Foundation-Devices/passport-assembly/Mechanical Design Files/Solidworks Files/FD-1842_Battery-PCBA_v04_REFERENCE.SLDASM

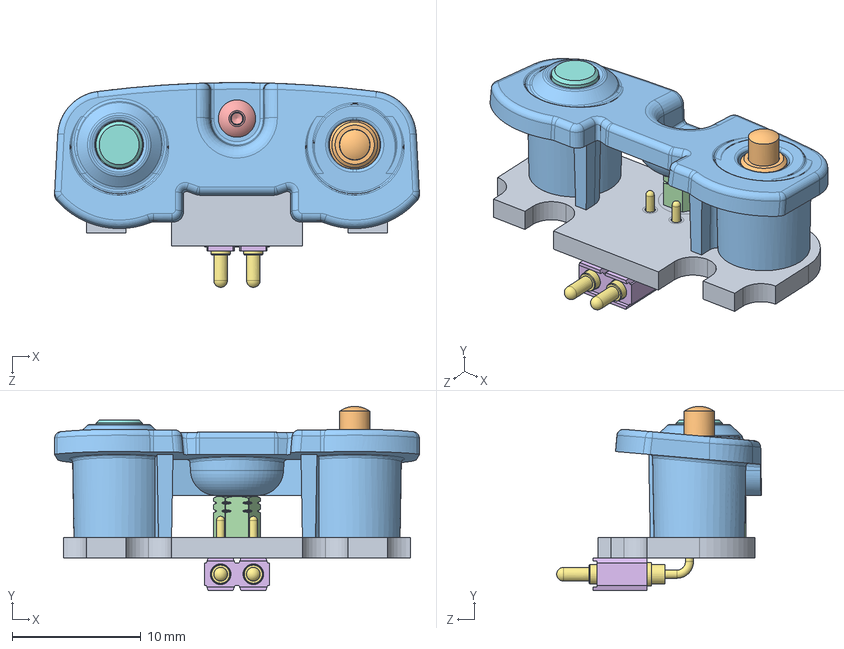
[picture p1: CAD file, 2021-05-18]
Mechanical Design Files/Solidworks Files/FD-1842_Battery-PCBA_v04_REFERENCE.SLDASM
28.3 x 14.3 x 15.9 mm
FD-1842_Battery-PCB_v04_REFERENCE
POGO-PIN_0871-0-15-20-82-14-11-0
FD_1842308-D_Battery-PCB-Chassis
NUT_PEM_SMTSO-080-4ET
SCREW_0-80_0188_BUTTON-HEX_92949A052
mill-max-829-22-002-20-002101_P8XX-11-013-30-000000
mill-max-829-22-002-20-002101_0970 x 2
mill-max-0393-0-15-15-07-XX-10-0
