Foundation-Devices/passport-assembly/Mechanical Design Files/Solidworks Files/FD-1842_Main-PCB_v03_REFERENCE.SLDPRT

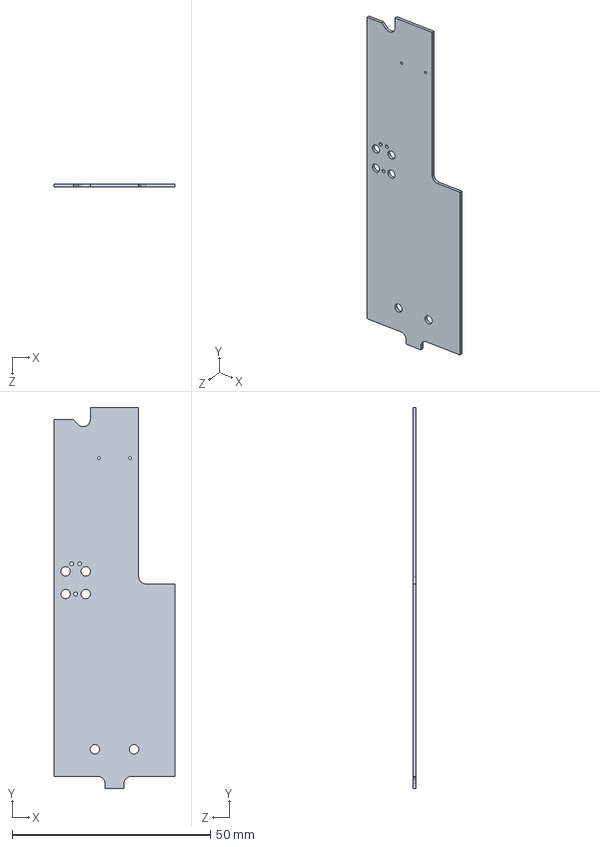
[picture p2: CAD file, 2021-05-18]
Mechanical Design Files/Solidworks Files/FD-1842_Main-PCB_v03_REFERENCE.SLDPRT
30.5 x 96.0 x 0.787 mm
