Foundation-Devices/passport-assembly/Mechanical Design Files/Solidworks Files/FD-1842_Dome-Array_v00.SLDASM

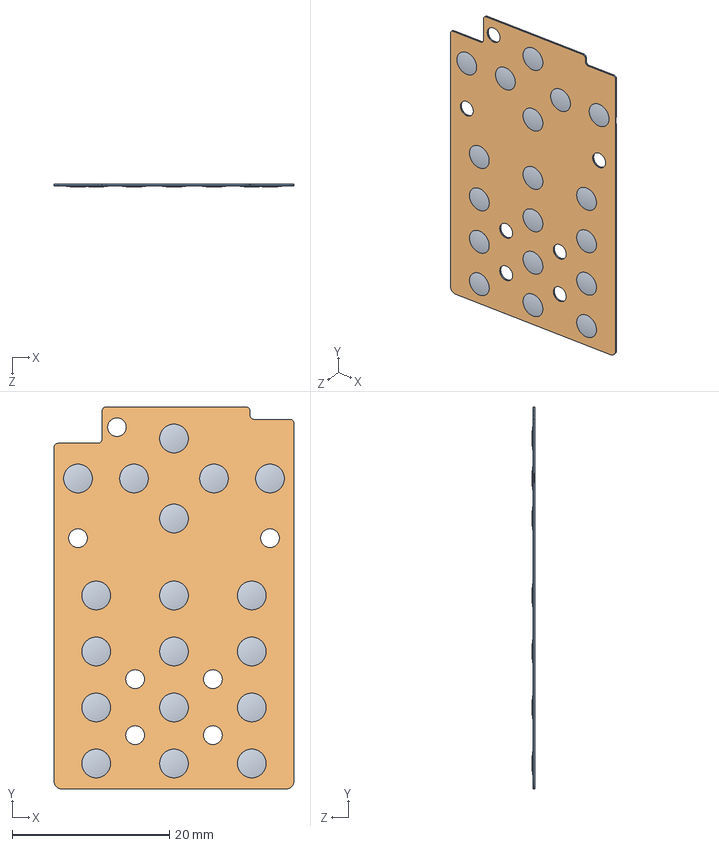
[picture p3: CAD file, 2021-05-18]
Mechanical Design Files/Solidworks Files/FD-1842_Dome-Array_v00.SLDASM
30.5 x 48.5 x 0.42 mm
DOME-SWITCH_6-SNL-170 x 18
005265042-A Dome Retainer-2020-09-04
005265043-A Dome Spacer-2020-09-04
