Foundation-Devices/passport-assembly/Mechanical Design Files/Solidworks Files/FD_1842102-B_Rear-Assem.SLDASM

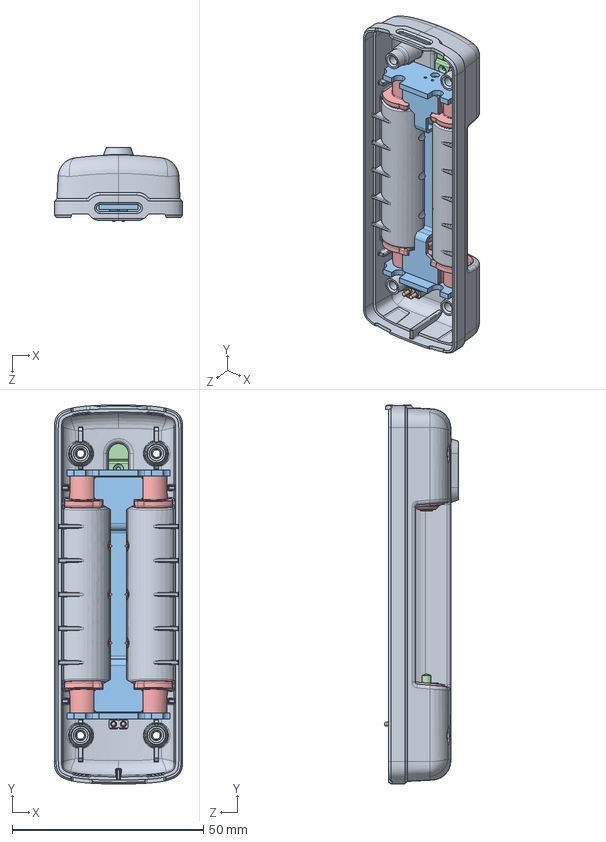
[picture p4: CAD file, 2021-05-18]
Mechanical Design Files/Solidworks Files/FD_1842102-B_Rear-Assem.SLDASM
33.5 x 99.1 x 19.5 mm
FD_1842301-C_Rear-Housing
MAGNET_0188-DIAx0188-H x 3
FD-1842_Battery-PCB_v04_REFERENCE x 2
POGO-PIN_0871-0-15-20-82-14-11-0 x 2
FD_1842308-D_Battery-PCB-Chassis x 2
NUT_PEM_SMTSO-080-4ET x 2
SCREW_0-80_0188_BUTTON-HEX_92949A052 x 2
mill-max-0393-0-15-15-07-XX-10-0 x 2
mill-max-829-22-002-20-002101_P8XX-11-013-30-000000
mill-max-829-22-002-20-002101_0970 x 2
FD_1842309-D_Retainer
FD_1842315-A_Flat-Camera-Shield
