Foundation-Devices/passport-assembly/Mechanical Design Files/Solidworks Files/FD_1842103-A_Rear-Cover-Assem.SLDASM

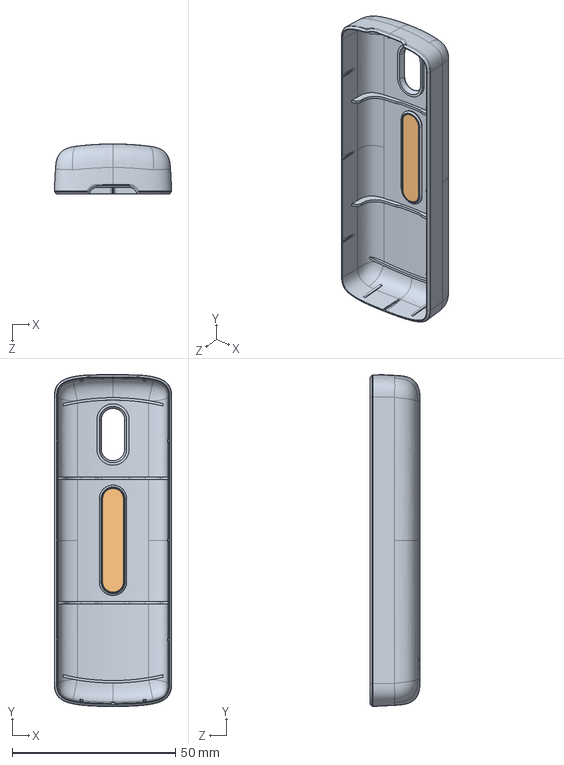
[picture p5: CAD file, 2021-05-18]
Mechanical Design Files/Solidworks Files/FD_1842103-A_Rear-Cover-Assem.SLDASM
36.0 x 101.6 x 15.4 mm
FD_1842302-C_Rear-Cover
FD_1842306-C_Steel-Plate
