Foundation-Devices/passport-assembly/Mechanical Design Files/STEP Files/FD_1842307-C_Bracket_SHEET-METAL-ONLY.STEP

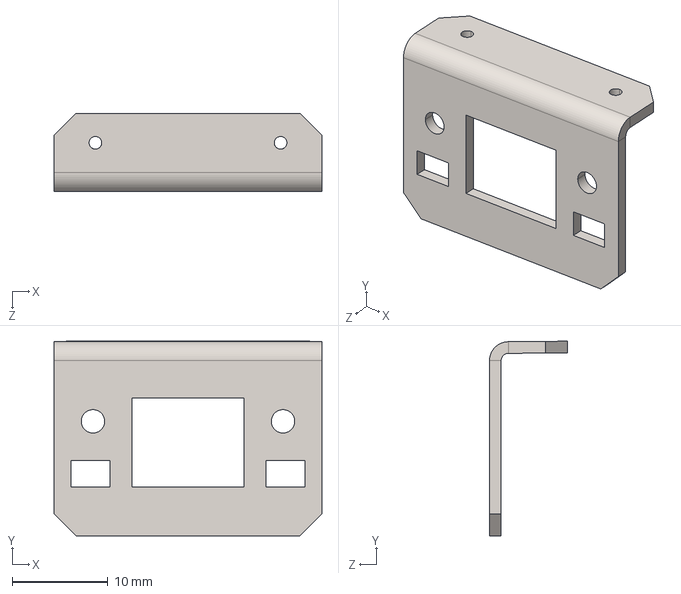
[picture p6: CAD file, 2021-05-18]
Mechanical Design Files/STEP Files/FD_1842307-C_Bracket_SHEET-METAL-ONLY.STEP
27.9 x 20.3 x 8.14 mm
