Foundation-Devices/passport-assembly/Mechanical Design Files/Solidworks Files/DOME-SWITCH_6-SNL-170.SLDPRT

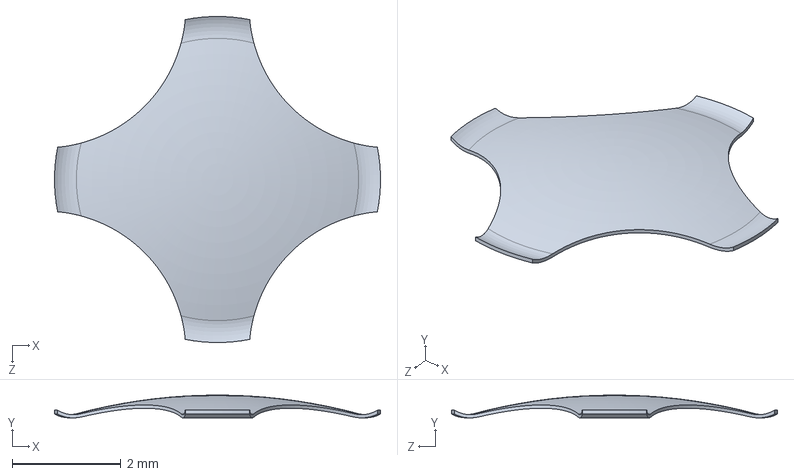
[picture p7: CAD file, 2021-05-18]
Mechanical Design Files/Solidworks Files/DOME-SWITCH_6-SNL-170.SLDPRT
6.00 x 0.42 x 6.00 mm
