Foundation-Devices/passport-assembly/Mechanical Design Files/STEP Files/FD_1842306-C_Steel-Plate.STEP

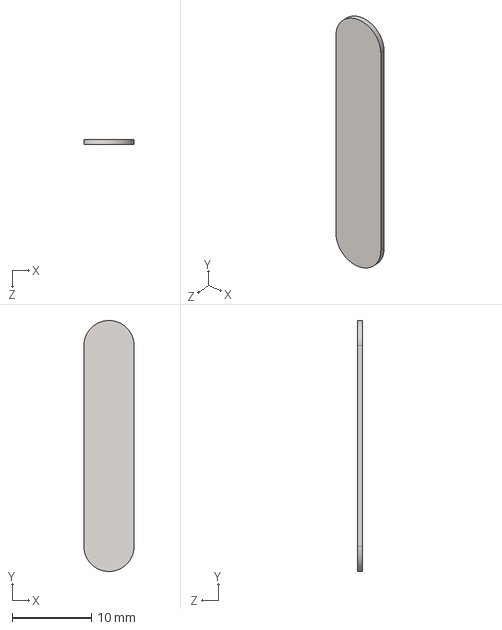
[picture p8: CAD file, 2021-05-18]
Mechanical Design Files/STEP Files/FD_1842306-C_Steel-Plate.STEP
6.35 x 31.8 x 0.61 mm
