Foundation-Devices/passport-assembly/Mechanical Design Files/Solidworks Files/FD-1842_Camera-PCB_v04_REFERENCE.SLDPRT

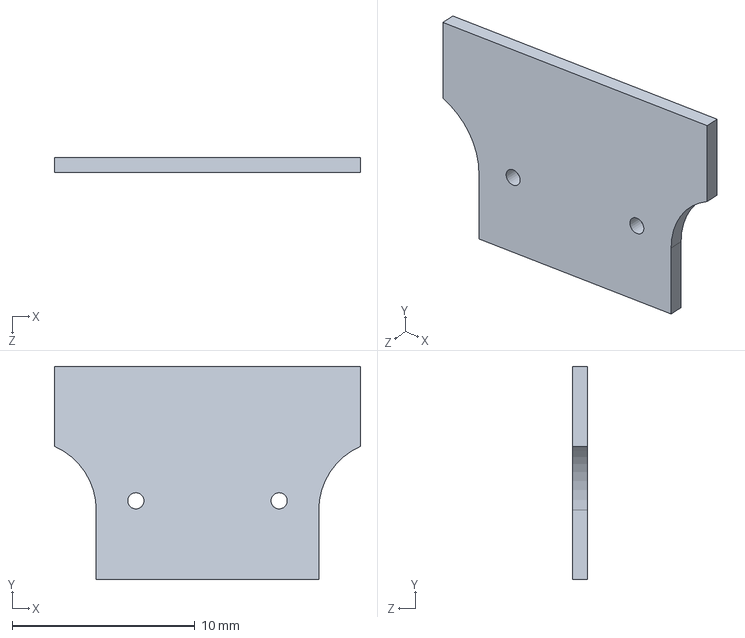
[picture p9: CAD file, 2021-05-18]
Mechanical Design Files/Solidworks Files/FD-1842_Camera-PCB_v04_REFERENCE.SLDPRT
16.8 x 11.7 x 0.813 mm
