Foundation-Devices/passport-assembly/Mechanical Design Files/STEP Files/FD_1842308-D_Battery-PCB-Chassis.STEP

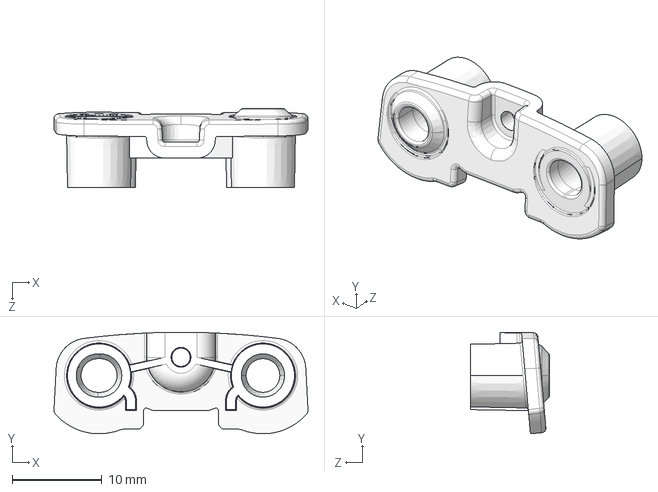
[picture p10: CAD file, 2021-05-18]
Mechanical Design Files/STEP Files/FD_1842308-D_Battery-PCB-Chassis.STEP
28.3 x 11.3 x 8.76 mm
