Foundation-Devices/passport-assembly/Mechanical Design Files/Solidworks Files/POGO-PIN_0871-0-15-20-82-14-11-0.SLDPRT

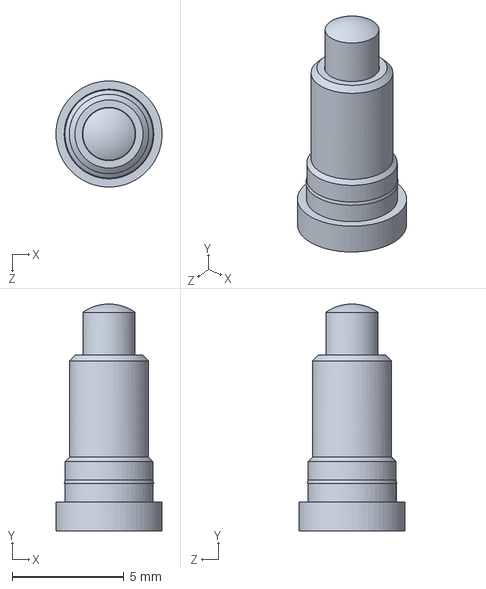
[picture p11: CAD file, 2021-05-18]
Mechanical Design Files/Solidworks Files/POGO-PIN_0871-0-15-20-82-14-11-0.SLDPRT
4.75 x 10.2 x 4.75 mm
