Foundation-Devices/passport-assembly/Mechanical Design Files/Solidworks Files/FD-JUL-CB1_PCB-2020-07-09.SLDPRT

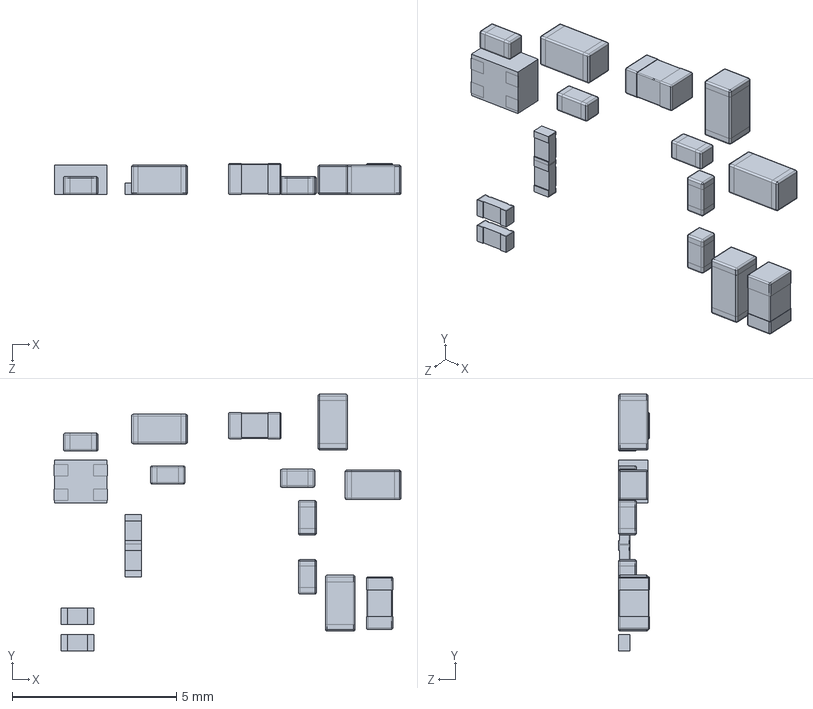
[picture p13: CAD file, 2021-05-18]
Mechanical Design Files/Solidworks Files/FD-JUL-CB1_PCB-2020-07-09.SLDPRT
10.6 x 7.81 x 0.953 mm
