Foundation-Devices/passport-assembly/Mechanical Design Files/STEP Files/FD_1842310-A_Light-Pipe.STEP

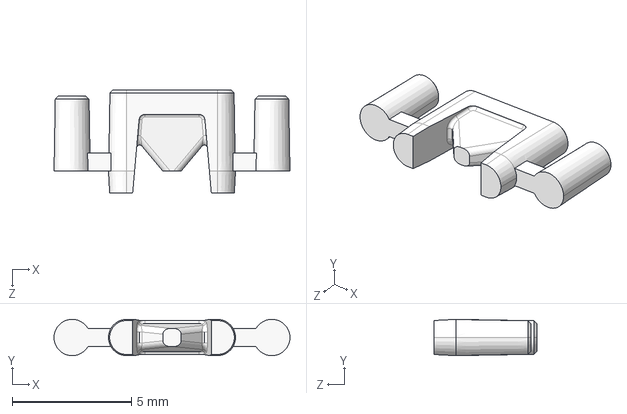
[picture p14: CAD file, 2021-05-18]
Mechanical Design Files/STEP Files/FD_1842310-A_Light-Pipe.STEP
9.91 x 1.52 x 4.32 mm
