Foundation-Devices/passport-assembly/Mechanical Design Files/Solidworks Files/FD_1842305-C_Camera-Shield.SLDPRT

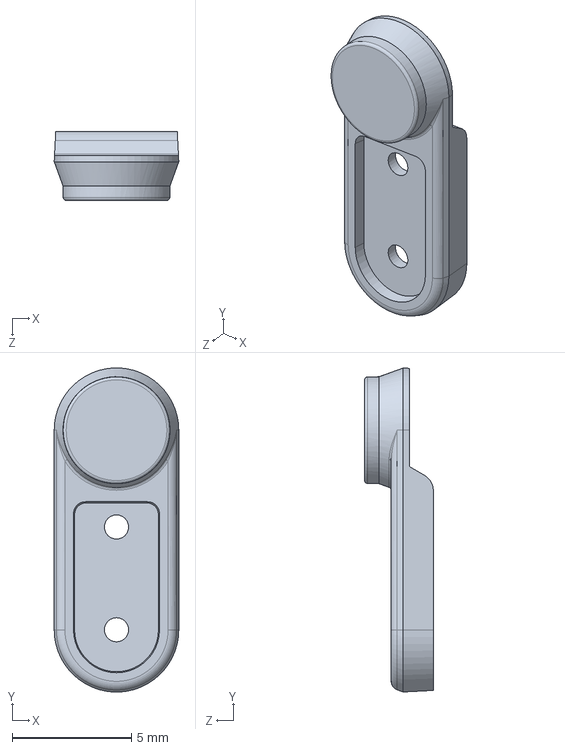
[picture p15: CAD file, 2021-05-18]
Mechanical Design Files/Solidworks Files/FD_1842305-C_Camera-Shield.SLDPRT
5.24 x 13.6 x 2.90 mm
