Foundation-Devices/passport-assembly/Mechanical Design Files/STEP Files/FD_1842312-A_Spacer.STEP

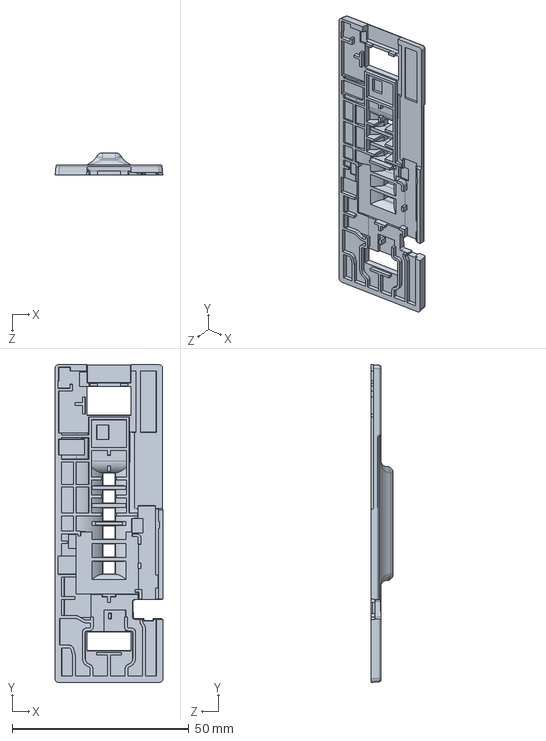
[picture p16: CAD file, 2021-05-18]
Mechanical Design Files/STEP Files/FD_1842312-A_Spacer.STEP
30.5 x 89.9 x 6.35 mm
