Foundation-Devices/passport-assembly/Mechanical Design Files/Solidworks Files/CAMERA_OVM7690-RYAA-BK.SLDPRT

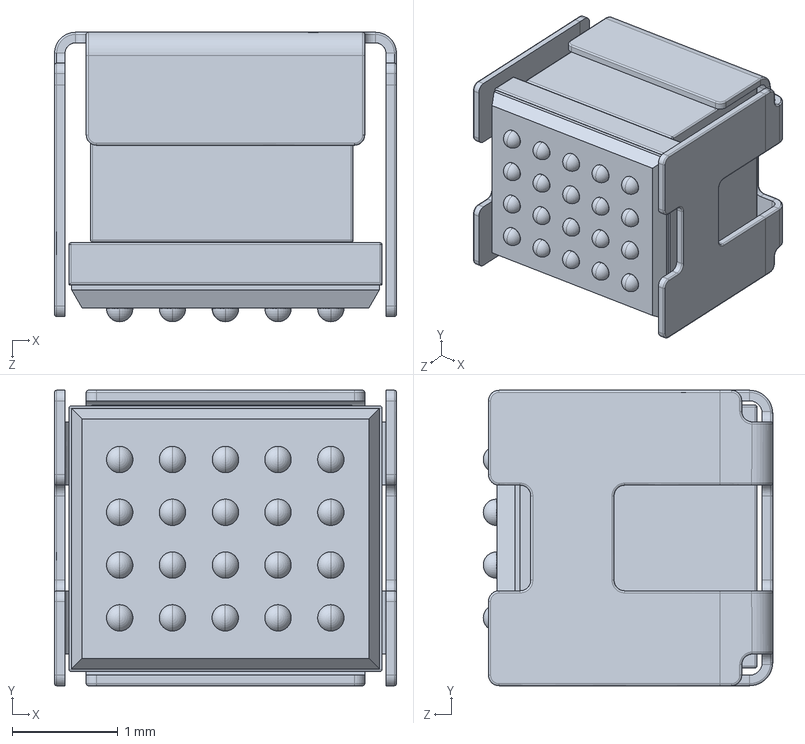
[picture p17: CAD file, 2021-05-18]
Mechanical Design Files/Solidworks Files/CAMERA_OVM7690-RYAA-BK.SLDPRT
3.24 x 2.80 x 2.74 mm
