Foundation-Devices/passport-assembly/Mechanical Design Files/STEP Files/FD_1842311-C_Display-Foam.STEP

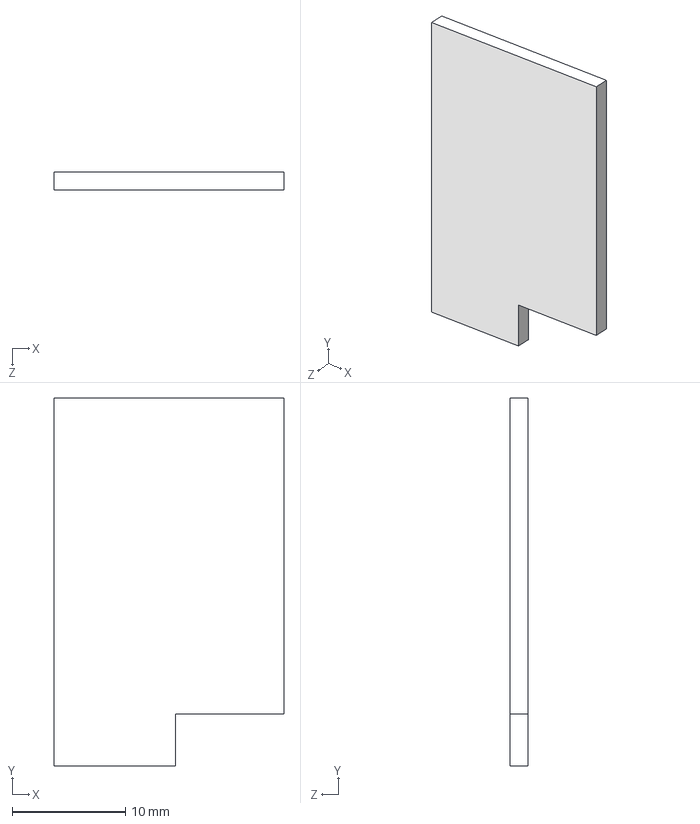
[picture p18: CAD file, 2021-05-18]
Mechanical Design Files/STEP Files/FD_1842311-C_Display-Foam.STEP
20.3 x 32.5 x 1.60 mm
