Foundation-Devices/passport-assembly/Mechanical Design Files/Solidworks Files/SD-CARD-RECEPTACLE_Molex-SD-47571-001.SLDPRT

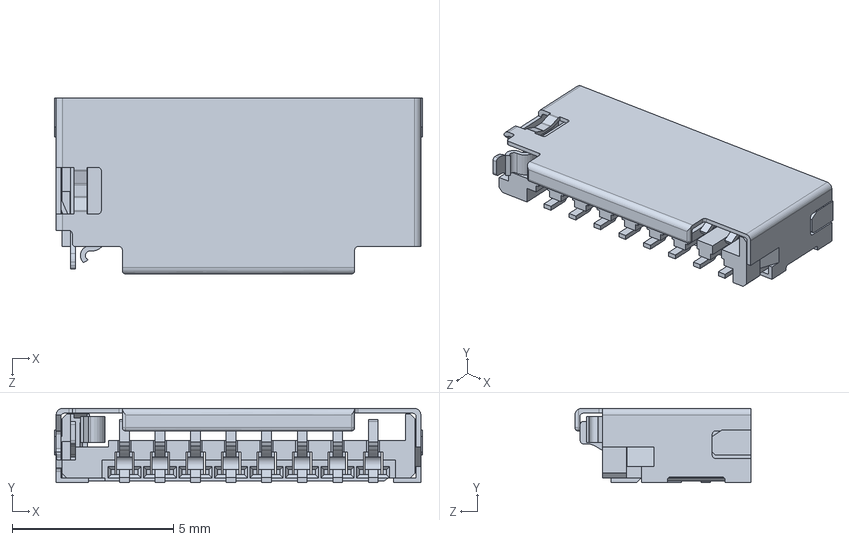
[picture p19: CAD file, 2021-05-18]
Mechanical Design Files/Solidworks Files/SD-CARD-RECEPTACLE_Molex-SD-47571-001.SLDPRT
11.4 x 2.30 x 5.45 mm
