Foundation-Devices/passport-assembly/Mechanical Design Files/STEP Files/FD_1842314-A_Programming-Fixture.STEP

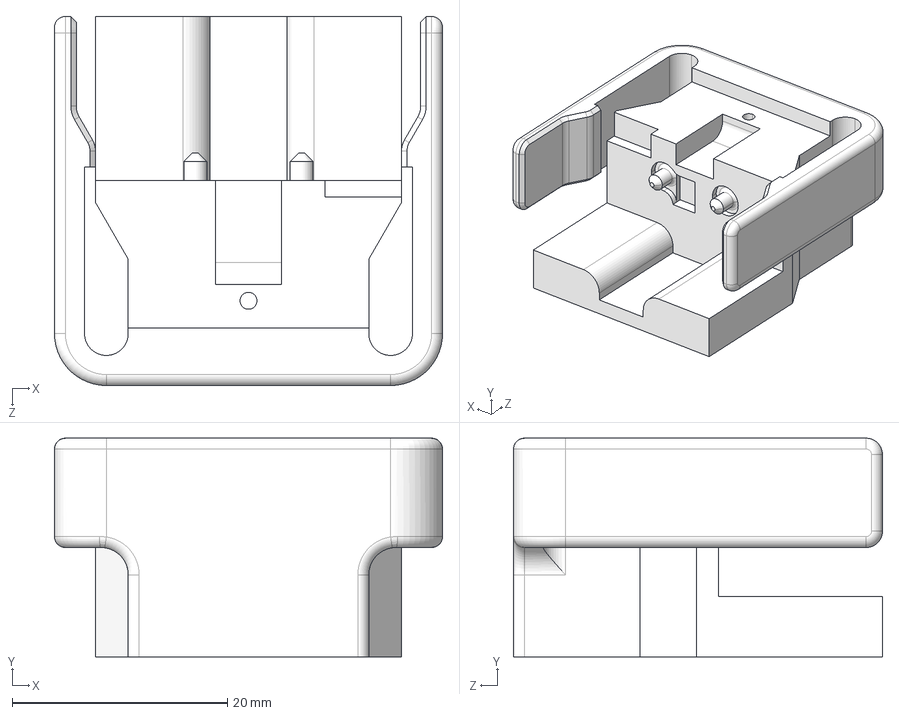
[picture p20: CAD file, 2021-05-18]
Mechanical Design Files/STEP Files/FD_1842314-A_Programming-Fixture.STEP
36.1 x 20.3 x 34.3 mm
