Foundation-Devices/passport-assembly/Mechanical Design Files/Solidworks Files/mill-max-0393-0-15-15-07-XX-10-0.SLDPRT

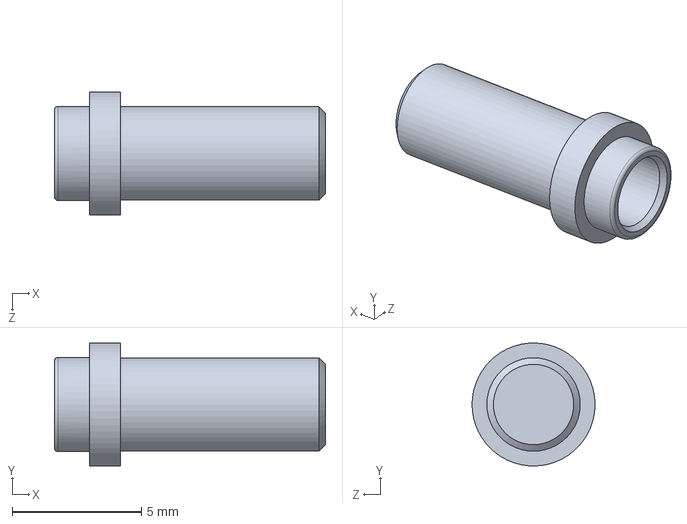
[picture p21: CAD file, 2021-05-18]
Mechanical Design Files/Solidworks Files/mill-max-0393-0-15-15-07-XX-10-0.SLDPRT
10.5 x 4.75 x 4.75 mm
