Foundation-Devices/passport-assembly/Mechanical Design Files/STEP Files/FD_1842309-D_Retainer.STEP

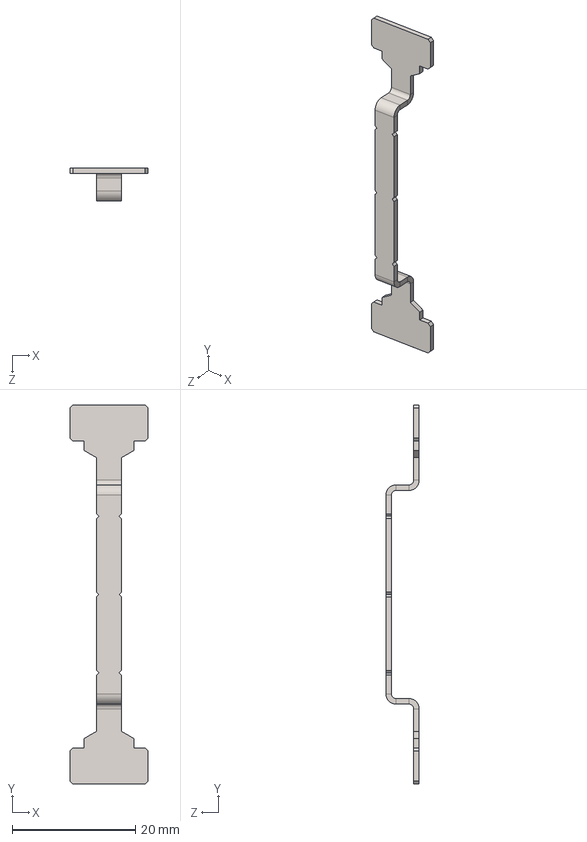
[picture p22: CAD file, 2021-05-18]
Mechanical Design Files/STEP Files/FD_1842309-D_Retainer.STEP
12.7 x 61.5 x 5.41 mm
