Foundation-Devices/passport-assembly/Mechanical Design Files/STEP Files/FD_1842307-C_Bracket.STEP

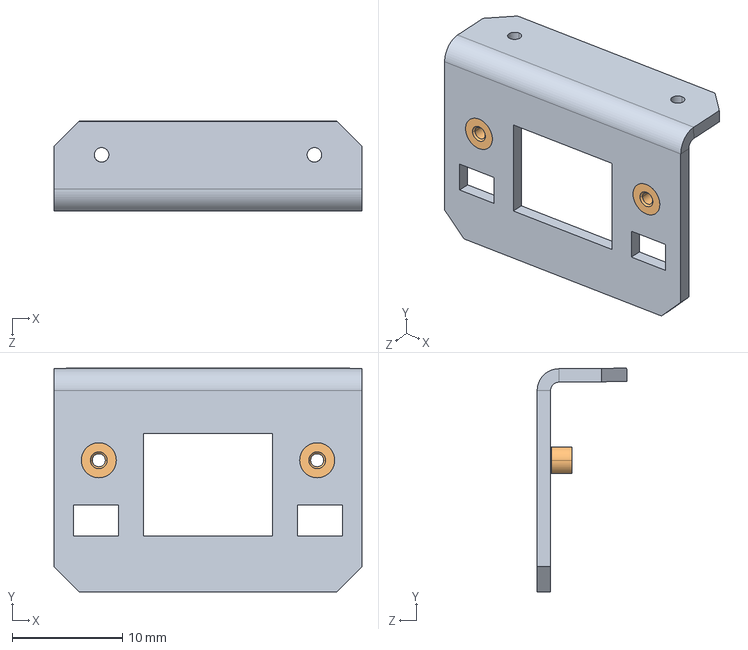
[picture p23: CAD file, 2021-05-18]
Mechanical Design Files/STEP Files/FD_1842307-C_Bracket.STEP
27.9 x 20.3 x 8.14 mm
FD_1842307-C_Bracket
STANDOFF_PEM_MSO4-080-4 x 2
