Foundation-Devices/passport-assembly/Mechanical Design Files/Solidworks Files/OPTICAL-SENSOR_ON-SEMI_LV0104CS.SLDPRT

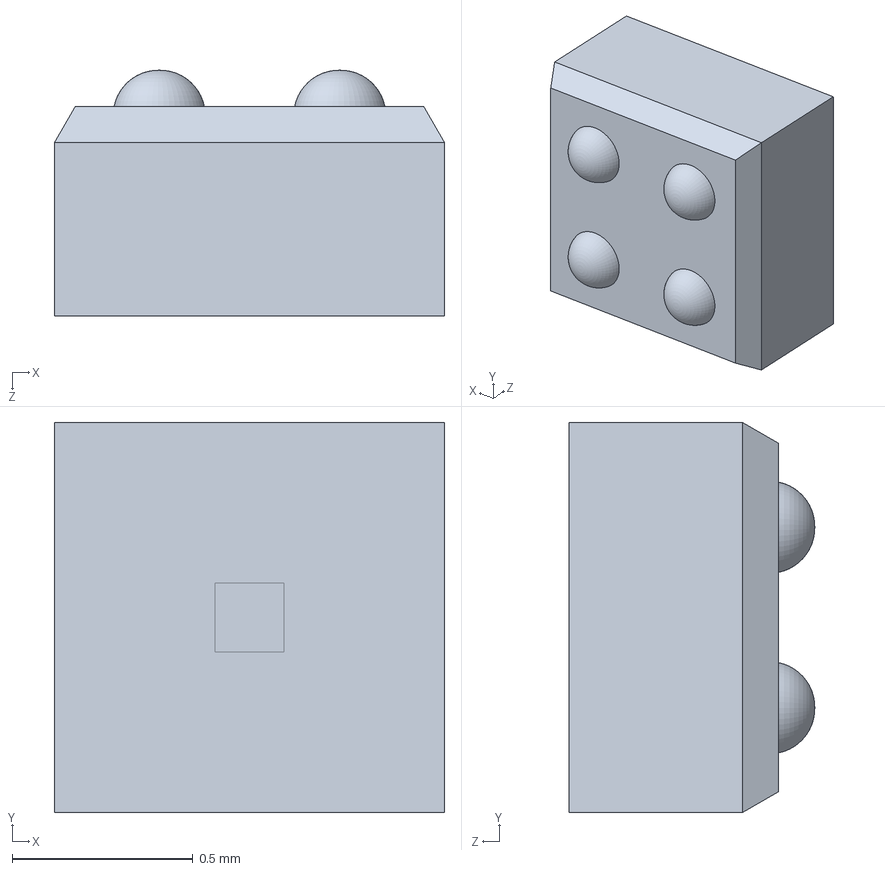
[picture p24: CAD file, 2021-05-18]
Mechanical Design Files/Solidworks Files/OPTICAL-SENSOR_ON-SEMI_LV0104CS.SLDPRT
1.08 x 1.08 x 0.68 mm
