Foundation-Devices/passport-assembly/Mechanical Design Files/STEP Files/FD_1842302-C_Rear-Cover.STEP

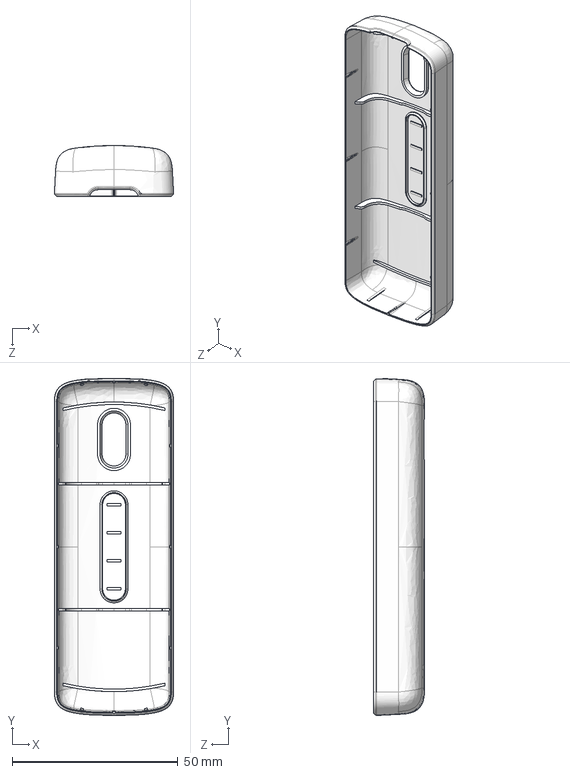
[picture p25: CAD file, 2021-05-18]
Mechanical Design Files/STEP Files/FD_1842302-C_Rear-Cover.STEP
36.0 x 101.6 x 15.4 mm
