Foundation-Devices/passport-assembly/Mechanical Design Files/Solidworks Files/MAGNET_0188-DIAx0188-H.SLDPRT

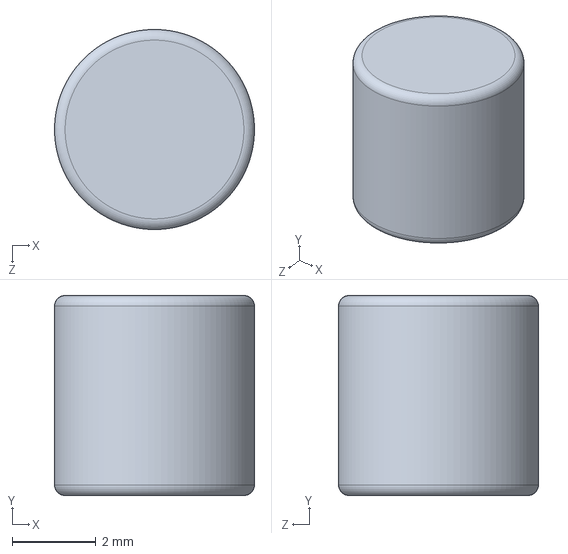
[picture p26: CAD file, 2021-05-18]
Mechanical Design Files/Solidworks Files/MAGNET_0188-DIAx0188-H.SLDPRT
4.77 x 4.78 x 4.77 mm
