Foundation-Devices/passport-assembly/Mechanical Design Files/STEP Files/FD_1842304-H_Display-Shield.STEP

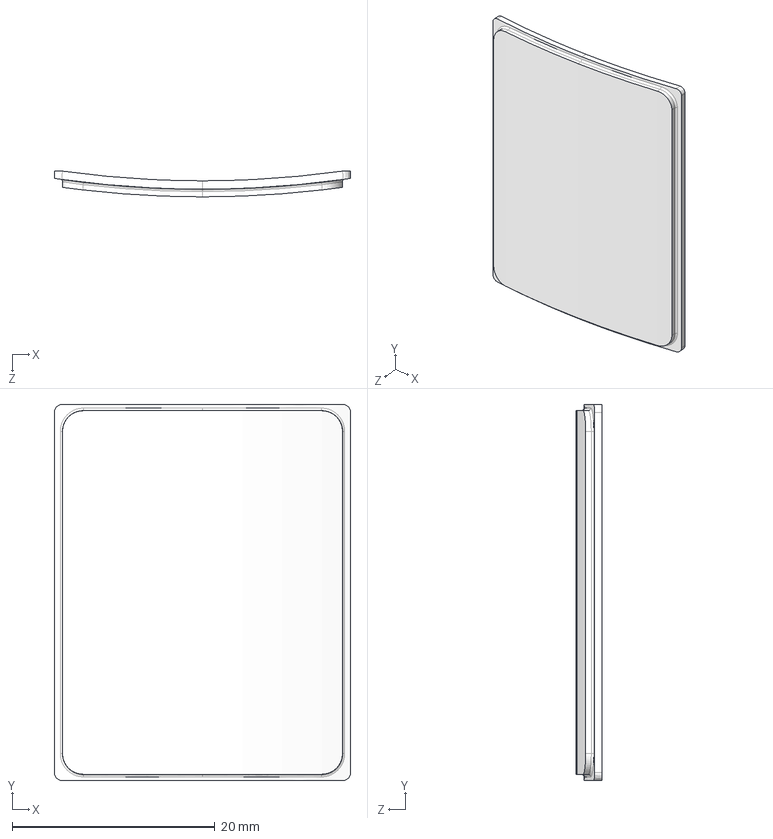
[picture p27: CAD file, 2021-05-18]
Mechanical Design Files/STEP Files/FD_1842304-H_Display-Shield.STEP
29.2 x 37.1 x 2.54 mm
