Foundation-Devices/passport-assembly/Mechanical Design Files/Solidworks Files/FD-1842_Battery-PCB_v04_REFERENCE.SLDPRT

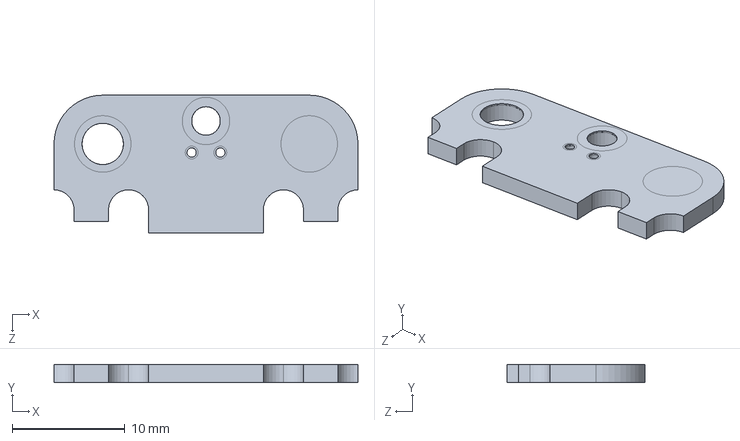
[picture p28: CAD file, 2021-05-18]
Mechanical Design Files/Solidworks Files/FD-1842_Battery-PCB_v04_REFERENCE.SLDPRT
26.9 x 1.60 x 12.2 mm
