Foundation-Devices/passport-assembly/Mechanical Design Files/Solidworks Files/mill-max-829-22-002-20-002101_P8XX-11-013-30-000000.sldprt

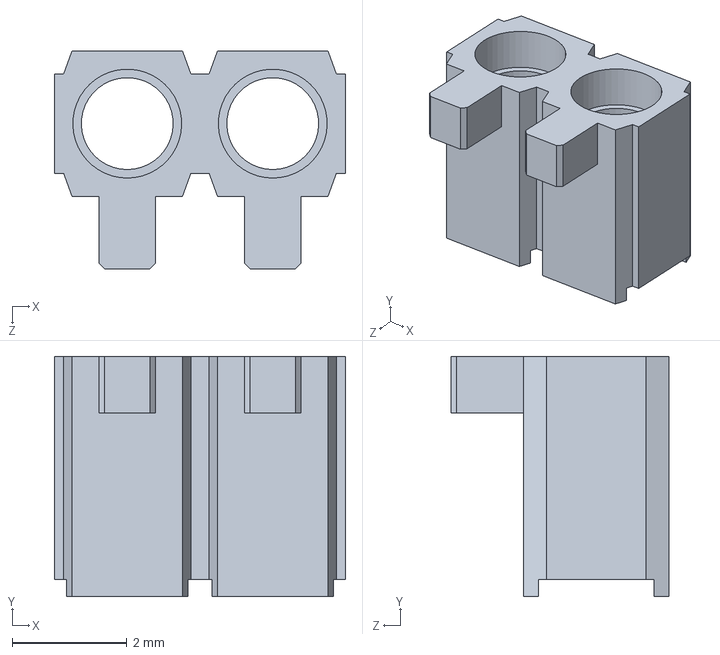
[picture p29: CAD file, 2021-05-18]
Mechanical Design Files/Solidworks Files/mill-max-829-22-002-20-002101_P8XX-11-013-30-000000.sldprt
5.08 x 4.19 x 3.81 mm
