Foundation-Devices/passport-assembly/Mechanical Design Files/Solidworks Files/FLEX-DISPLAY_FLAT-ROLL_12616-06_T2_prelim_08-28-2019_REF.SLDPRT

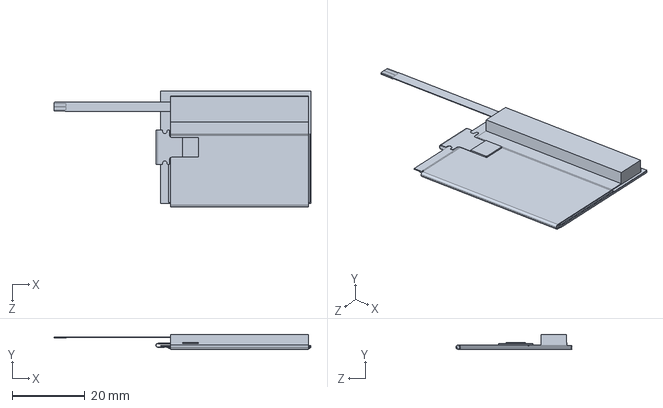
[picture p30: CAD file, 2021-05-18]
Mechanical Design Files/Solidworks Files/FLEX-DISPLAY_FLAT-ROLL_12616-06_T2_prelim_08-28-2019_REF.SLDPRT
70.8 x 4.06 x 32.0 mm
