Foundation-Devices/passport-assembly/Mechanical Design Files/Solidworks Files/mill-max-829-22-002-20-002101_0970.sldprt

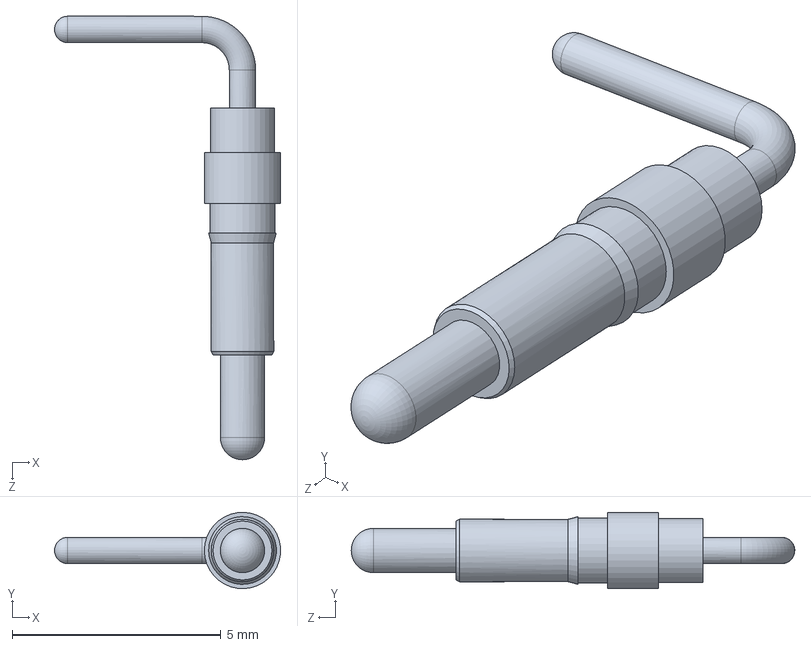
[picture p31: CAD file, 2021-05-18]
Mechanical Design Files/Solidworks Files/mill-max-829-22-002-20-002101_0970.sldprt
5.42 x 1.83 x 10.6 mm
