Foundation-Devices/passport-assembly/Mechanical Design Files/Solidworks Files/DISPLAY-RECEPTACLE_TE-CONNECTIVITY_1-2328702-0.SLDPRT

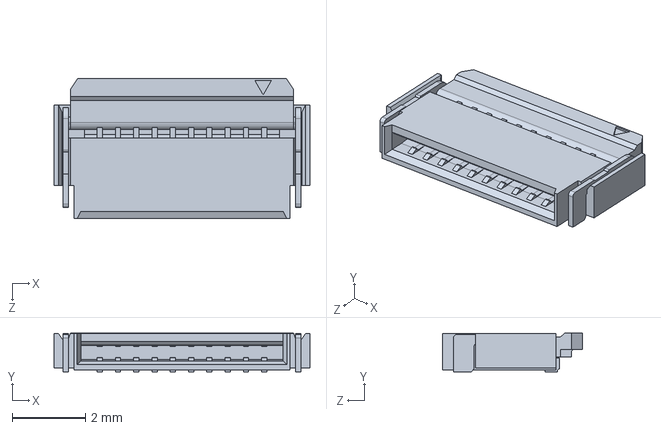
[picture p32: CAD file, 2021-05-18]
Mechanical Design Files/Solidworks Files/DISPLAY-RECEPTACLE_TE-CONNECTIVITY_1-2328702-0.SLDPRT
7.00 x 1.06 x 3.83 mm
