Foundation-Devices/passport-assembly/Mechanical Design Files/Solidworks Files/Battery-AAA.SLDPRT

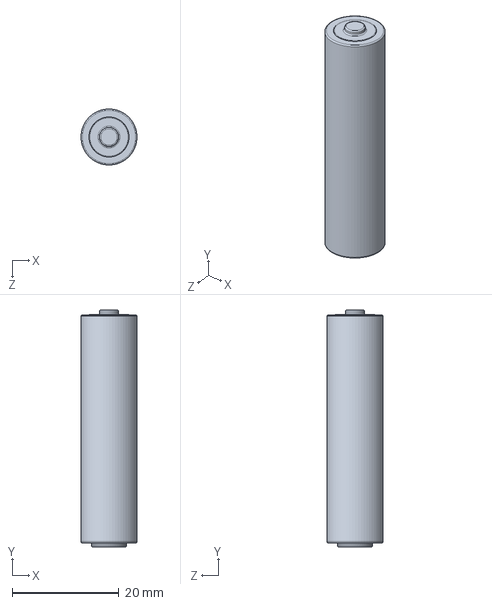
[picture p33: CAD file, 2021-05-18]
Mechanical Design Files/Solidworks Files/Battery-AAA.SLDPRT
10.5 x 44.4 x 10.5 mm
