Foundation-Devices/passport-assembly/Mechanical Design Files/Solidworks Files/LED_LTST-C190XXXX.SLDPRT

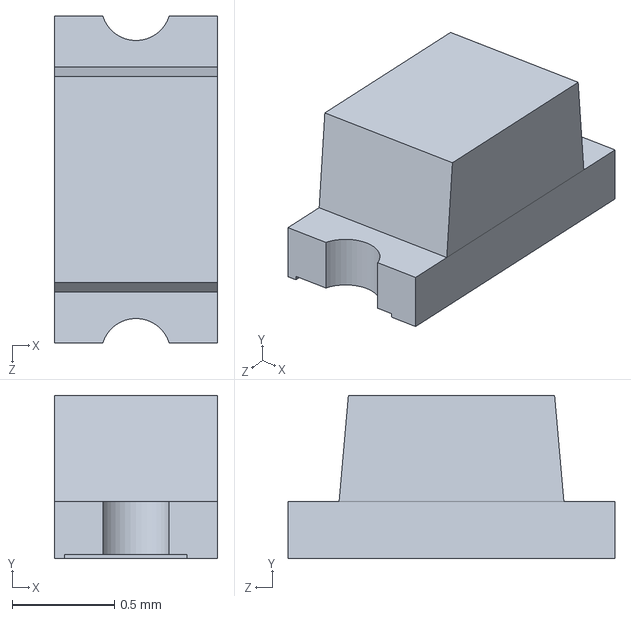
[picture p34: CAD file, 2021-05-18]
Mechanical Design Files/Solidworks Files/LED_LTST-C190XXXX.SLDPRT
0.8 x 0.8 x 1.60 mm
