Foundation-Devices/passport-assembly/Mechanical Design Files/Solidworks Files/XT_FD-JL-PCBA-CB_D3_2020-11-23-2.SLDPRT

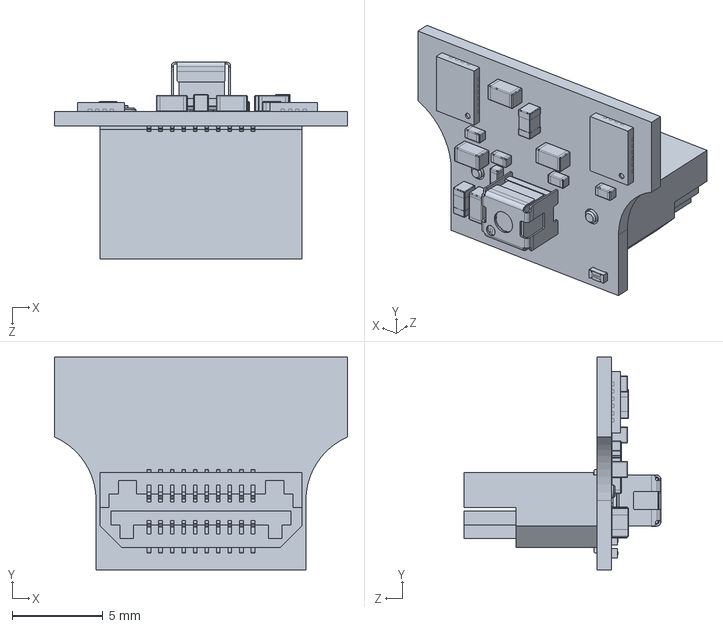
[picture p35: CAD file, 2021-05-18]
Mechanical Design Files/Solidworks Files/XT_FD-JL-PCBA-CB_D3_2020-11-23-2.SLDPRT
16.1 x 11.7 x 10.8 mm
