Foundation-Devices/passport-assembly/Mechanical Design Files/Solidworks Files/STANDOFF_PEM_MSO4-080-4.SLDPRT

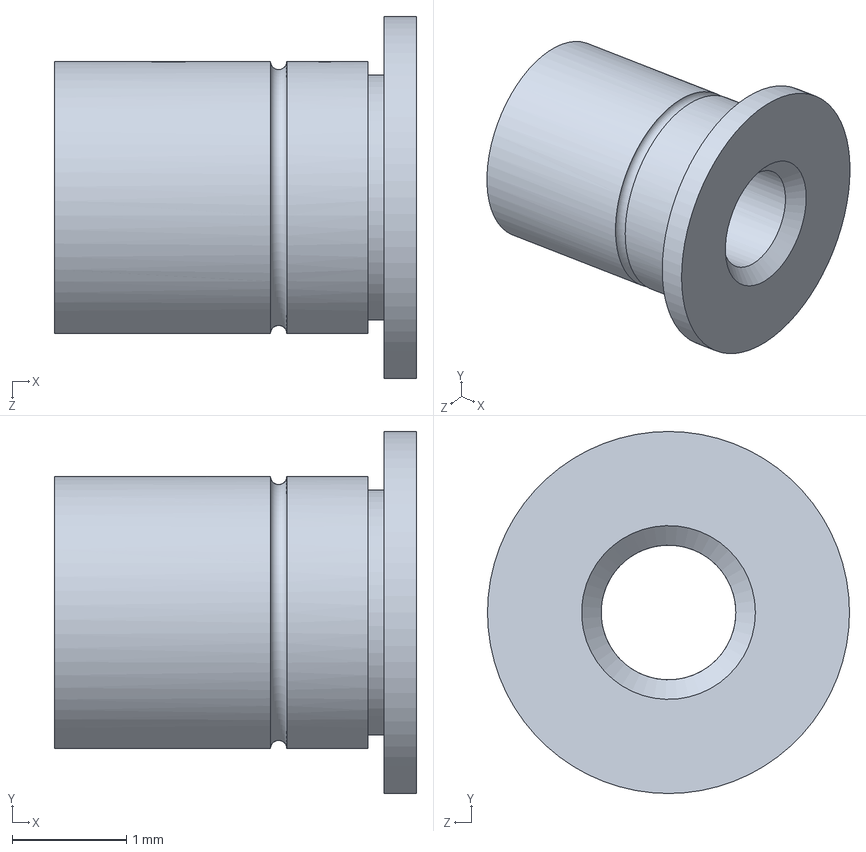
[picture p36: CAD file, 2021-05-18]
Mechanical Design Files/Solidworks Files/STANDOFF_PEM_MSO4-080-4.SLDPRT
3.17 x 3.17 x 3.17 mm
