Foundation-Devices/passport-assembly/(list of files, cad)

Other CAD files:
Mechanical Design Files/Archive/Original Camera Shield/FD_1842305-C_Camera-Shield.STEP
Mechanical Design Files/Archive/Original Camera Shield/FD_1842305-C_Camera-Shield.STL
Mechanical Design Files/DXF Files/FD_1842311-C_Display-Foam.DXF
Mechanical Design Files/DXF Files/FD_1842315-A_Flat-Camera-Shield.DXF
Mechanical Design Files/STL Files/FD_1842304-H_Display-Shield.STL
Mechanical Design Files/STL Files/FD_1842306-C_Steel-Plate.STL
Mechanical Design Files/STL Files/FD_1842307-C_Bracket.STL
Mechanical Design Files/STL Files/FD_1842307-C_Bracket_SHEET-METAL-ONLY.STL
Mechanical Design Files/STL Files/FD_1842309-D_Retainer.STL
Mechanical Design Files/STL Files/FD_1842310-A_Light-Pipe.STL
Mechanical Design Files/STL Files/FD_1842311-C_Display-Foam.STL
Mechanical Design Files/STL Files/FD_1842312-A_Spacer.STL
Mechanical Design Files/STL Files/FD_1842314-A_Programming-Fixture.STL
Mechanical Design Files/STL Files/FD_1842315-A_Flat-Camera-Shield.STL
Mechanical Design Files/Solidworks Files/005265012-A Assembly, Keypad-2020-09-04.sldasm
Mechanical Design Files/Solidworks Files/005265021-A Keytop, Set-2020-09-04.sldprt
Mechanical Design Files/Solidworks Files/005265032-A Keypad, Base-2020-09-04.sldprt
Mechanical Design Files/Solidworks Files/005265041-A Metal Dome Array-2020-09-04.sldasm
Mechanical Design Files/Solidworks Files/005265042-A Dome Retainer-2020-09-04.sldprt
Mechanical Design Files/Solidworks Files/005265043-A Dome Spacer-2020-09-04.sldprt
Mechanical Design Files/Solidworks Files/FD-1842_Dome-Array_v00.SLDPRT
Mechanical Design Files/Solidworks Files/FD_1842302-C_Rear-Cover.SLDPRT
Mechanical Design Files/Solidworks Files/FD_1842304-H_Display-Shield.SLDPRT
Mechanical Design Files/Solidworks Files/FD_1842306-C_Steel-Plate.SLDPRT
Mechanical Design Files/Solidworks Files/FD_1842307-C_Bracket.SLDASM
Mechanical Design Files/Solidworks Files/FD_1842307-C_Bracket.SLDPRT
Mechanical Design Files/Solidworks Files/FD_1842307-C_Bracket_SHEET-METAL-ONLY.SLDPRT
Mechanical Design Files/Solidworks Files/FD_1842308-D_Battery-PCB-Chassis.SLDPRT
Mechanical Design Files/Solidworks Files/FD_1842309-D_Retainer.SLDPRT
Mechanical Design Files/Solidworks Files/FD_1842310-A_Light-Pipe.SLDPRT
Mechanical Design Files/Solidworks Files/FD_1842311-C_Display-Foam.SLDPRT
Mechanical Design Files/Solidworks Files/FD_1842312-A_Spacer.SLDPRT
Mechanical Design Files/Solidworks Files/FD_1842315-A_Flat-Camera-Shield.SLDPRT
Mechanical Design Files/Solidworks Files/NUT_PEM_SMTSO-080-4ET.SLDPRT
Mechanical Design Files/Solidworks Files/SCREW_0-80_0188_BUTTON-HEX_92949A052.SLDPRT
