Foundation-Devices/passport-assembly/Mechanical Design Files/PDF Drawings/FD_1842300-H_Front-Housing.PDF

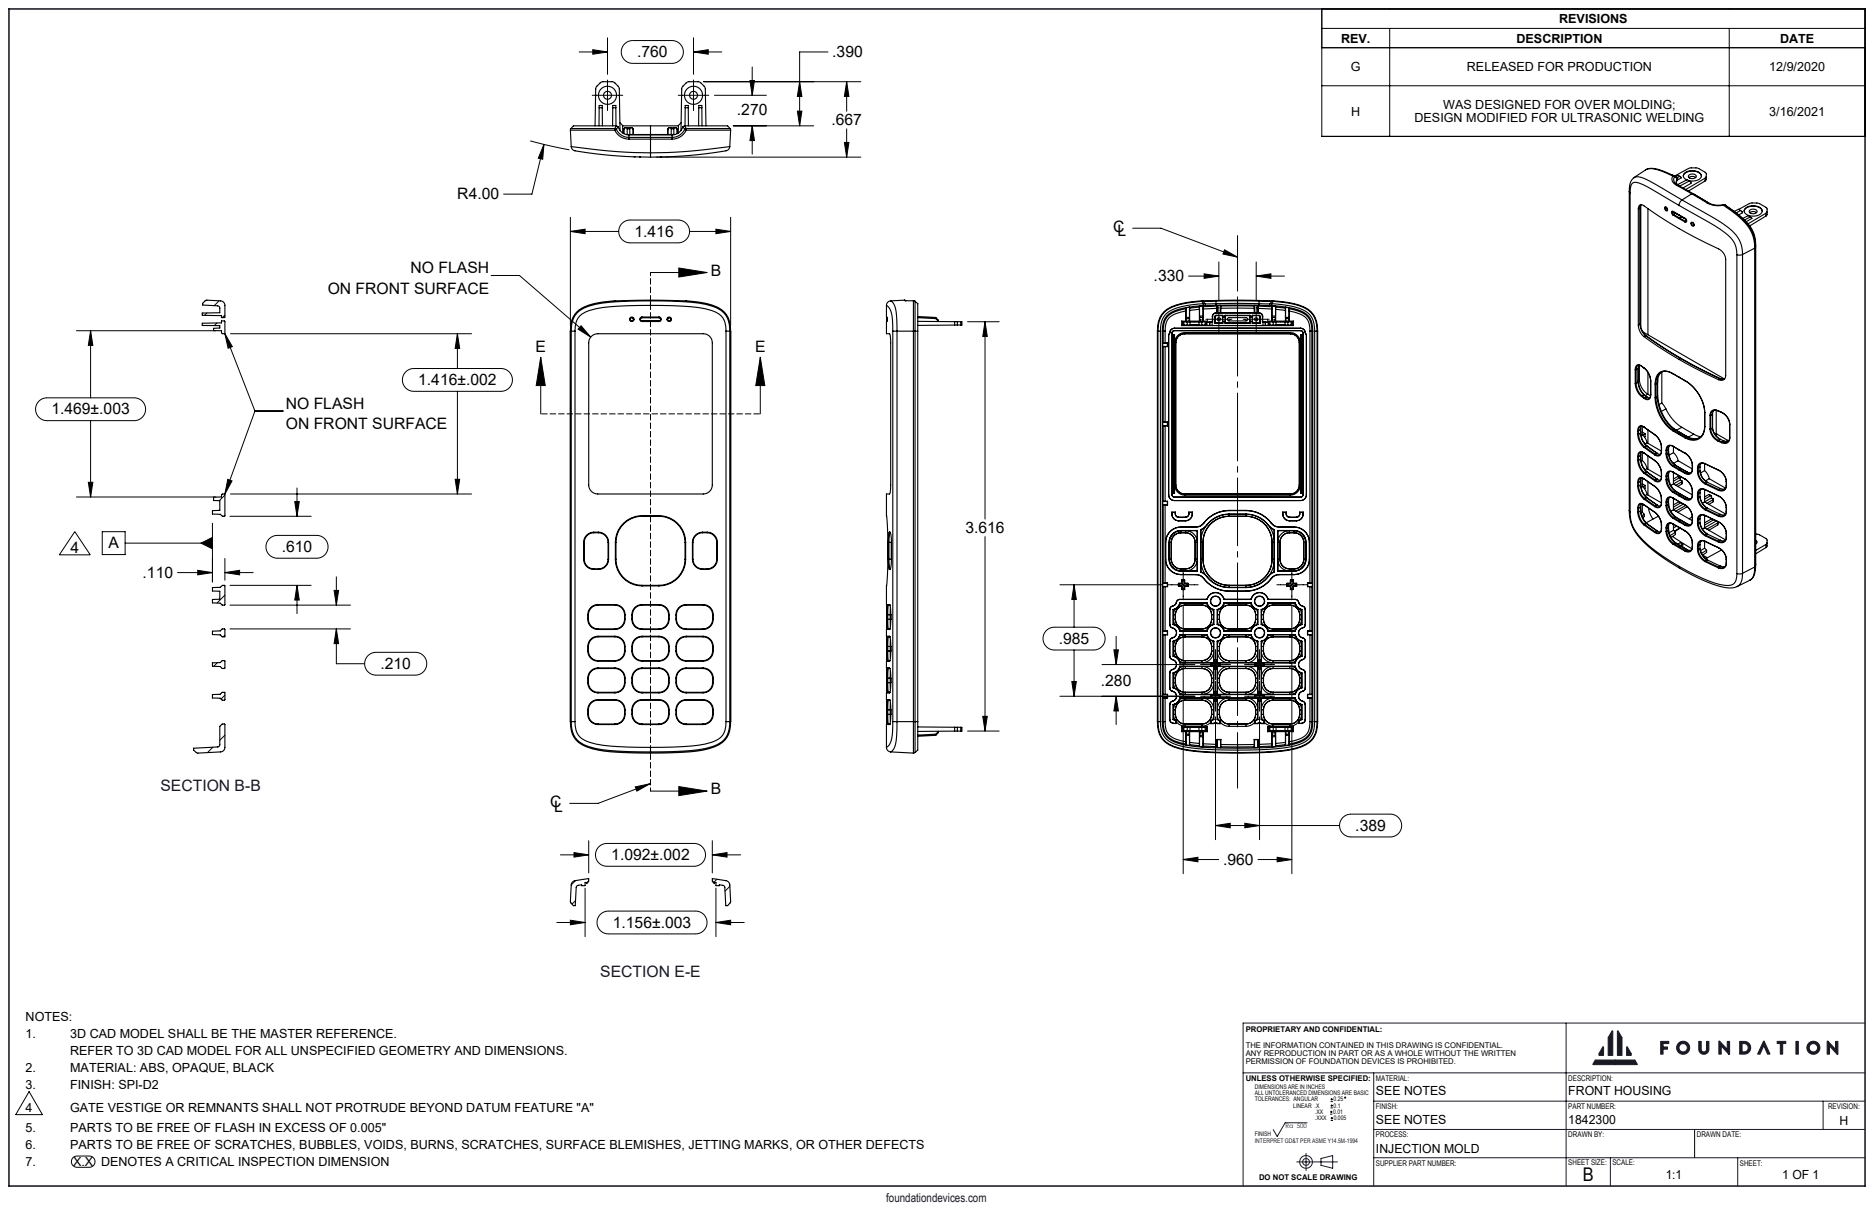
[picture p37: page 1]
NO FLASH; SECTION B-B; SECTION E-E; GATE VESTIGE OR REMNANTS SHALL NOT PROTRUDE BEYOND DATUM FEATURE "A"

REVISIONS

REV. | DESCRIPTION | DATE
G | RELEASED FOR PRODUCTION | 12/9/2020

H | WAS DESIGNED FOR OVER MOLDING; DESIGN MODIFIED FOR ULTRASONIC WELDING | 3/16/2021

ON FRONT SURFACE

NO FLASH

NOTES:
1. 3D CAD MODEL SHALL BE THE MASTER REFERENCE.
REFER TO 3D CAD MODEL FOR ALL UNSPECIFIED GEOMETRY AND DIMENSIONS.
2. MATERIAL: ABS, OPAQUE, BLACK
3. FINISH: SPI-D2
5. PARTS TO BE FREE OF FLASH IN EXCESS OF 0.005"
6. PARTS TO BE FREE OF SCRATCHES, BUBBLES, VOIDS, BURNS, SCRATCHES, SURFACE BLEMISHES, JETTING MARKS, OR OTHER DEFECTS
7. X.X DENOTES A CRITICAL INSPECTION DIMENSION

PROPRIETARY AND CONFIDENTIAL: THE INFORMATION CONTAINED IN THIS DRAWING IS CONFIDENTIAL. ANY REPRODUCTION IN PART OR AS A WHOLE WITHOUT THE WRITTEN PERMISSION OF FOUNDATION DEVICES IS PROHIBITED.

UNLESS OTHERWISE SPECIFIED: DIMENSIONS ARE IN INCHES ALL UNTOLERANCED DIMENSIONS ARE BASIC TOLERANCES: ANGULAR 0.25 LINEAR .X 0.1 .XX 0.01 .XXX 0.005 Ra 500 FINISH INTERPRET GD&T PER ASME Y14.5M-1994 DO NOT SCALE DRAWING | MATERIAL: SEE NOTES | DESCRIPTION: FRONT HOUSING

FINISH: SEE NOTES | PART NUMBER: 1842300 | REVISION: H

PROCESS: INJECTION MOLD | DRAWN BY: | DRAWN DATE:
SUPPLIER PART NUMBER: | SHEET SIZE: B | SCALE: 1:1 | SHEET: 1 OF 1
