Foundation-Devices/passport-assembly/Mechanical Design Files/PDF Drawings/FD_1842302-C_Rear-Cover.PDF

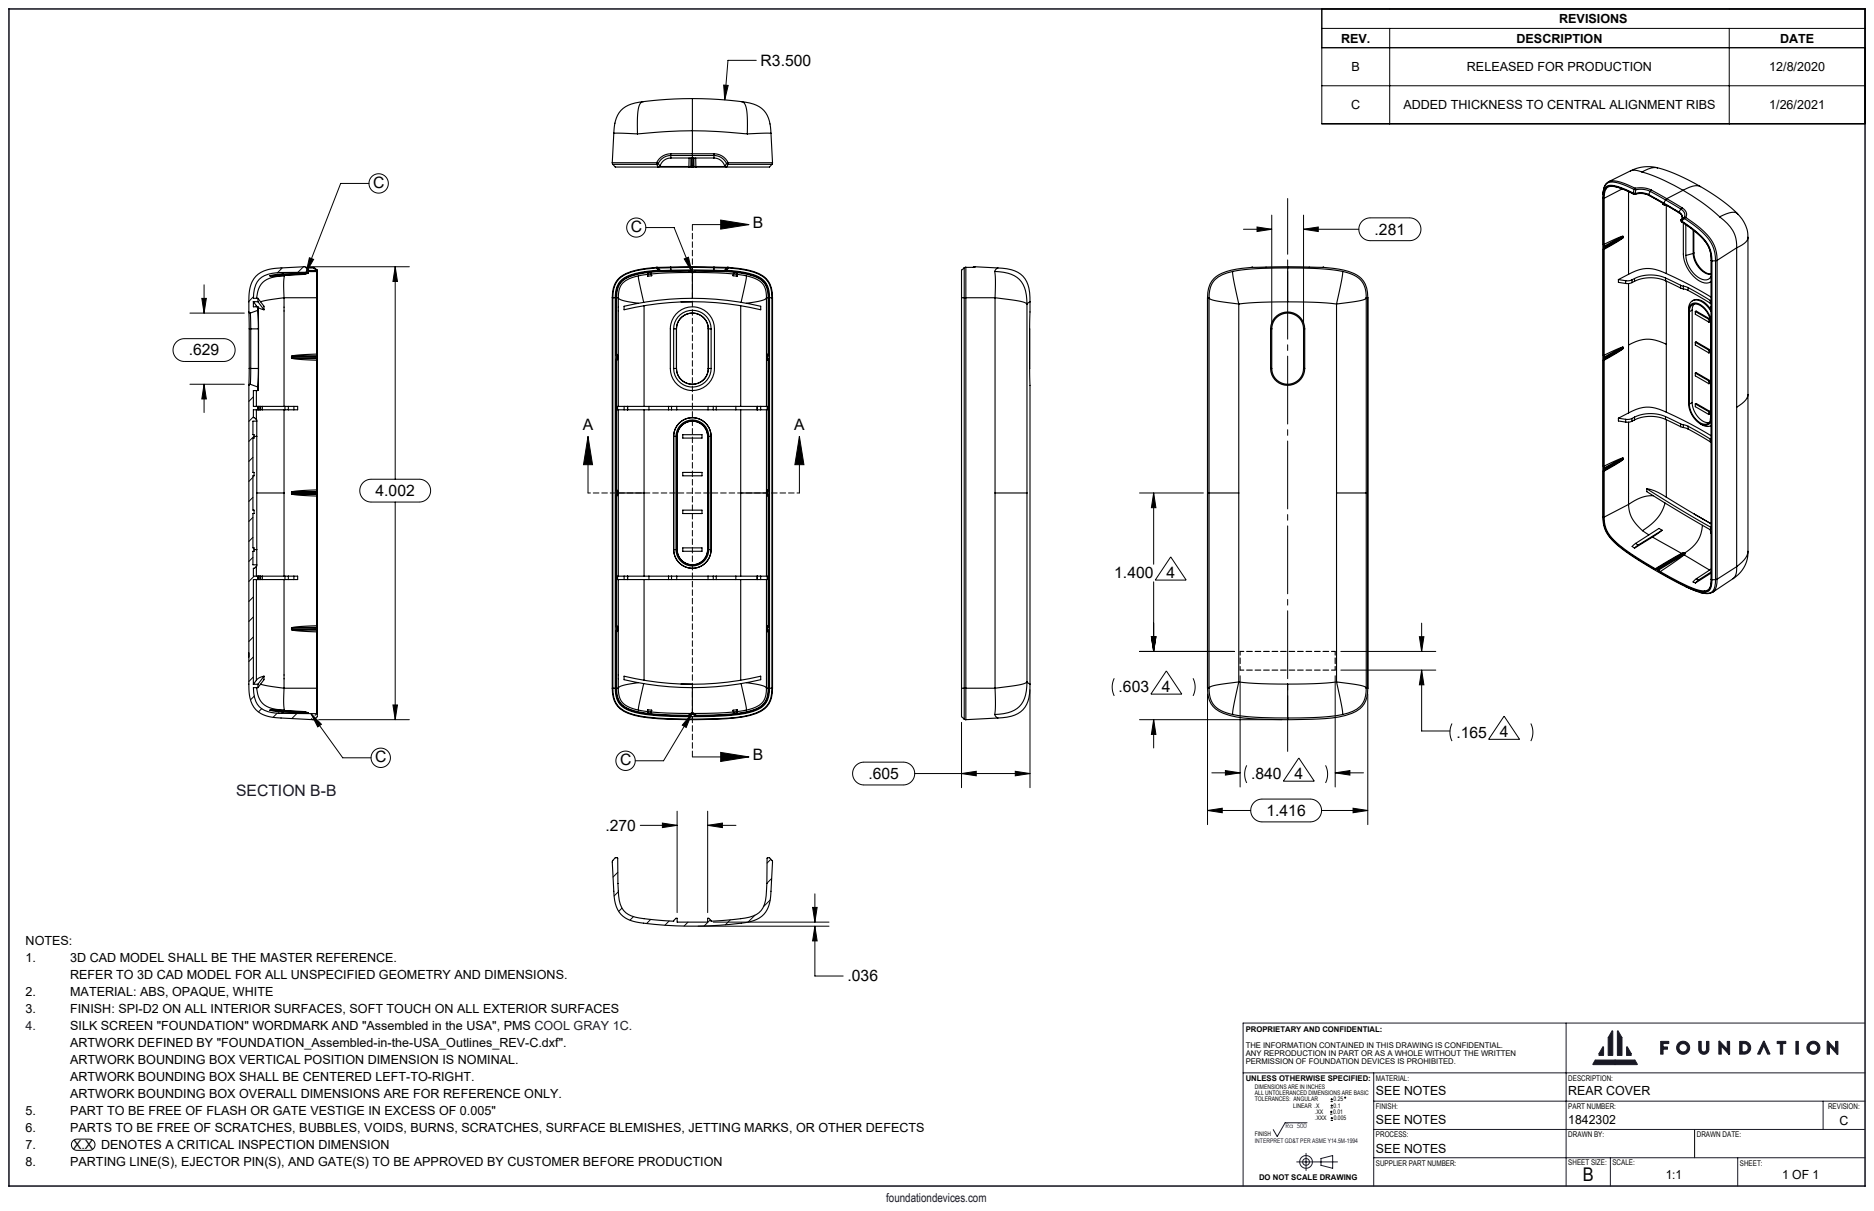
[picture p38: page 1]
SECTION B-B

REVISIONS

REV. | DESCRIPTION | DATE
B | RELEASED FOR PRODUCTION | 12/8/2020

C | ADDED THICKNESS TO CENTRAL ALIGNMENT RIBS | 1/26/2021

NOTES:
1. 3D CAD MODEL SHALL BE THE MASTER REFERENCE.
REFER TO 3D CAD MODEL FOR ALL UNSPECIFIED GEOMETRY AND DIMENSIONS.
2. MATERIAL: ABS, OPAQUE, WHITE
3. FINISH: SPI-D2 ON ALL INTERIOR SURFACES, SOFT TOUCH ON ALL EXTERIOR SURFACES
4. SILK SCREEN "FOUNDATION" WORDMARK AND "Assembled in the USA", PMS COOL GRAY 1C.
ARTWORK DEFINED BY "FOUNDATION_Assembled-in-the-USA_Outlines_REV-C.dxf".
ARTWORK BOUNDING BOX VERTICAL POSITION DIMENSION IS NOMINAL.
ARTWORK BOUNDING BOX SHALL BE CENTERED LEFT-TO-RIGHT.
ARTWORK BOUNDING BOX OVERALL DIMENSIONS ARE FOR REFERENCE ONLY.
5. PART TO BE FREE OF FLASH OR GATE VESTIGE IN EXCESS OF 0.005"
6. PARTS TO BE FREE OF SCRATCHES, BUBBLES, VOIDS, BURNS, SCRATCHES, SURFACE BLEMISHES, JETTING MARKS, OR OTHER DEFECTS
7. X.X DENOTES A CRITICAL INSPECTION DIMENSION
8. PARTING LINE(S), EJECTOR PIN(S), AND GATE(S) TO BE APPROVED BY CUSTOMER BEFORE PRODUCTION

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

UNLESS OTHERWISE SPECIFIED: DIMENSIONS ARE IN INCHES ALL UNTOLERANCED DIMENSIONS ARE BASIC TOLERANCES: ANGULAR 0.25 LINEAR .X 0.1 .XX 0.01 .XXX 0.005 Ra 500 FINISH INTERPRET GD&T PER ASME Y14.5M-1994 DO NOT SCALE DRAWING | MATERIAL: SEE NOTES | DESCRIPTION: REAR COVER

FINISH: SEE NOTES | PART NUMBER: 1842302 | REVISION: C

PROCESS: SEE NOTES | DRAWN BY: | DRAWN DATE:
SUPPLIER PART NUMBER: | SHEET SIZE: B | SCALE: 1:1 | SHEET: 1 OF 1
