Foundation-Devices/passport-assembly/Mechanical Design Files/PDF Drawings/FD_1842304-H_Display-Shield.PDF

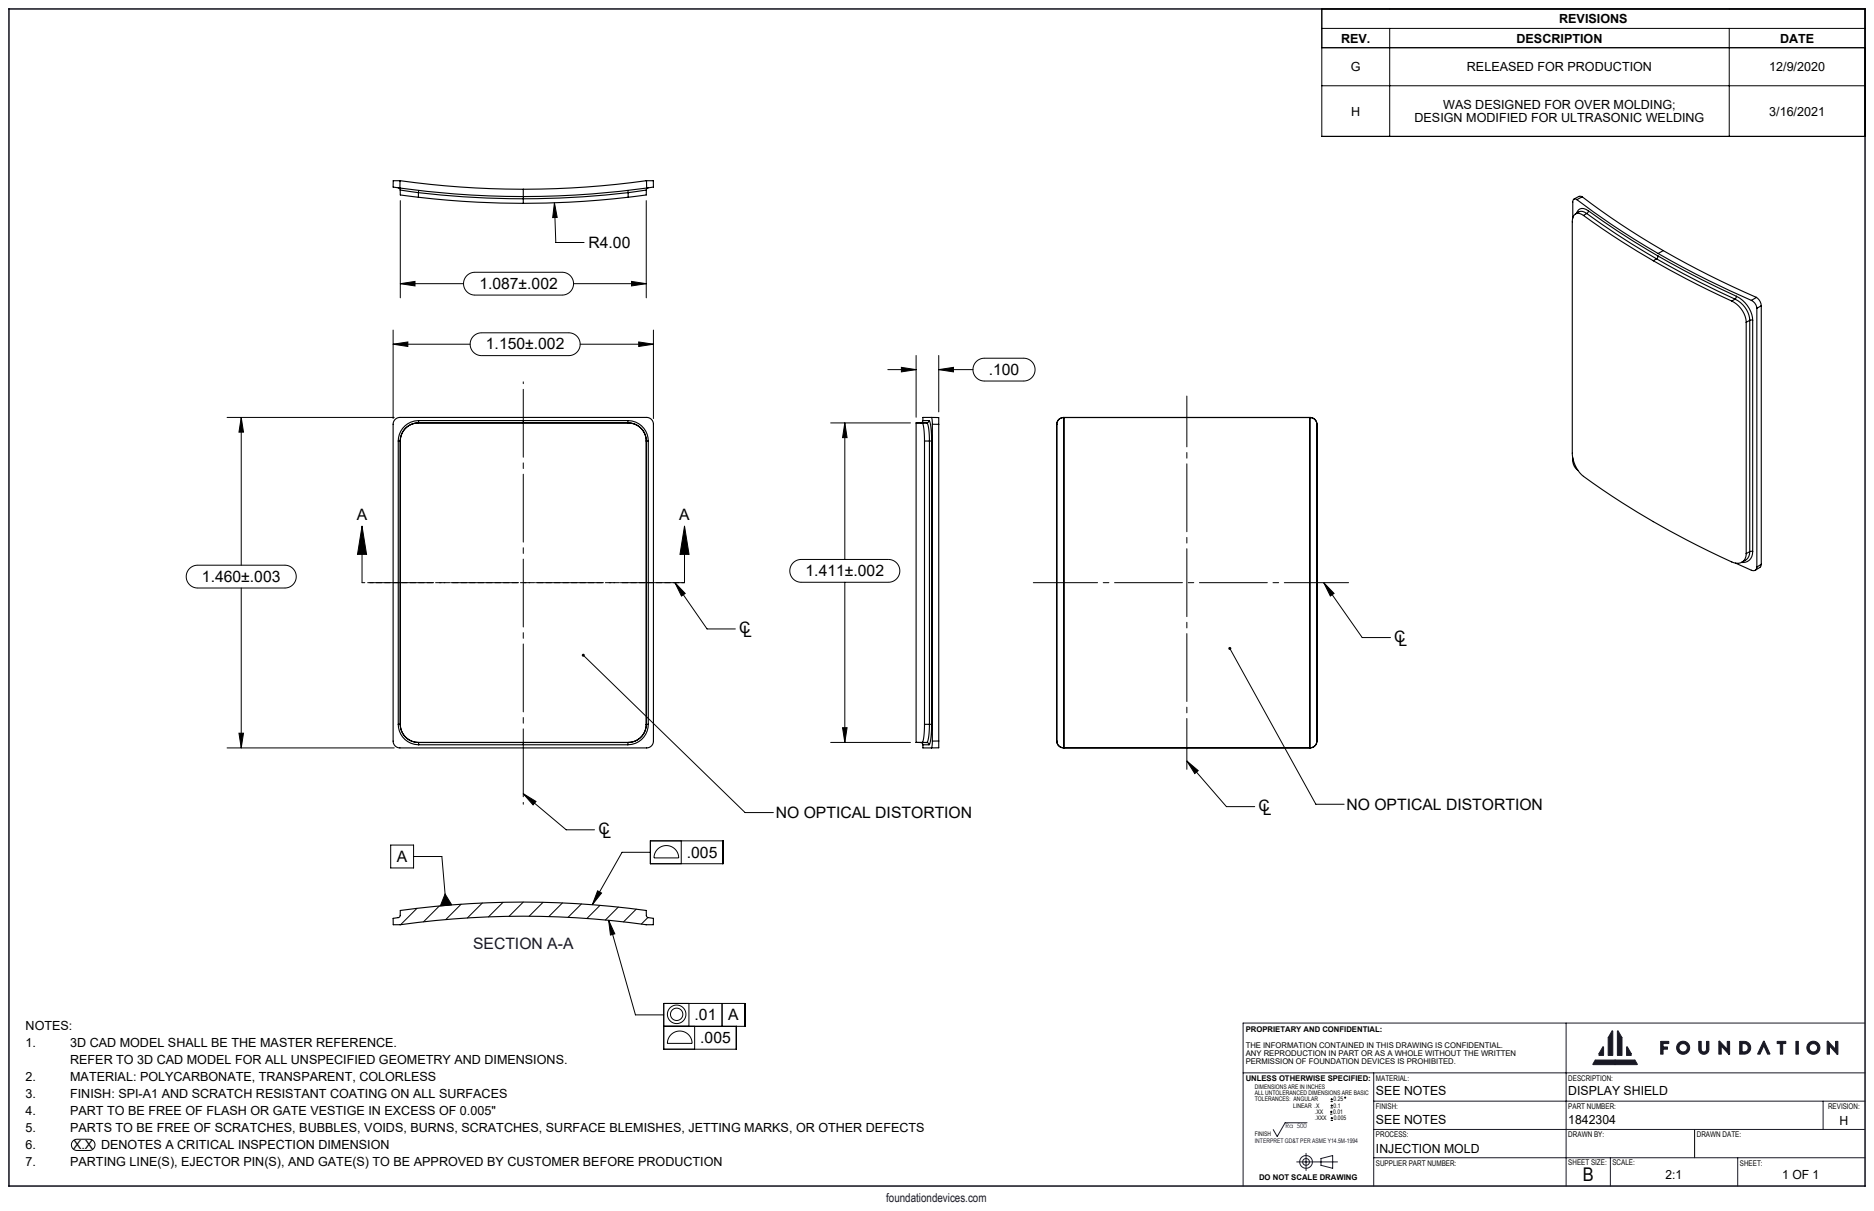
[picture p39: page 1]
NO OPTICAL DISTORTION; SECTION A-A

REVISIONS

REV. | DESCRIPTION | DATE
G | RELEASED FOR PRODUCTION | 12/9/2020

H | WAS DESIGNED FOR OVER MOLDING; DESIGN MODIFIED FOR ULTRASONIC WELDING | 3/16/2021

NO OPTICAL DISTORTION

NOTES:
1. 3D CAD MODEL SHALL BE THE MASTER REFERENCE.
REFER TO 3D CAD MODEL FOR ALL UNSPECIFIED GEOMETRY AND DIMENSIONS.
2. MATERIAL: POLYCARBONATE, TRANSPARENT, COLORLESS
3. FINISH: SPI-A1 AND SCRATCH RESISTANT COATING ON ALL SURFACES
4. PART TO BE FREE OF FLASH OR GATE VESTIGE IN EXCESS OF 0.005"
5. PARTS TO BE FREE OF SCRATCHES, BUBBLES, VOIDS, BURNS, SCRATCHES, SURFACE BLEMISHES, JETTING MARKS, OR OTHER DEFECTS
6. X.X DENOTES A CRITICAL INSPECTION DIMENSION
7. PARTING LINE(S), EJECTOR PIN(S), AND GATE(S) TO BE APPROVED BY CUSTOMER BEFORE PRODUCTION

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

UNLESS OTHERWISE SPECIFIED: DIMENSIONS ARE IN INCHES ALL UNTOLERANCED DIMENSIONS ARE BASIC TOLERANCES: ANGULAR 0.25 LINEAR .X 0.1 .XX 0.01 .XXX 0.005 Ra 500 FINISH INTERPRET GD&T PER ASME Y14.5M-1994 DO NOT SCALE DRAWING | MATERIAL: SEE NOTES | DESCRIPTION: DISPLAY SHIELD

FINISH: SEE NOTES | PART NUMBER: 1842304 | REVISION: H

PROCESS: INJECTION MOLD | DRAWN BY: | DRAWN DATE:
SUPPLIER PART NUMBER: | SHEET SIZE: B | SCALE: 2:1 | SHEET: 1 OF 1
