Foundation-Devices/passport-assembly/Mechanical Design Files/PDF Drawings/FD_1842306-C_Steel-Plate.PDF

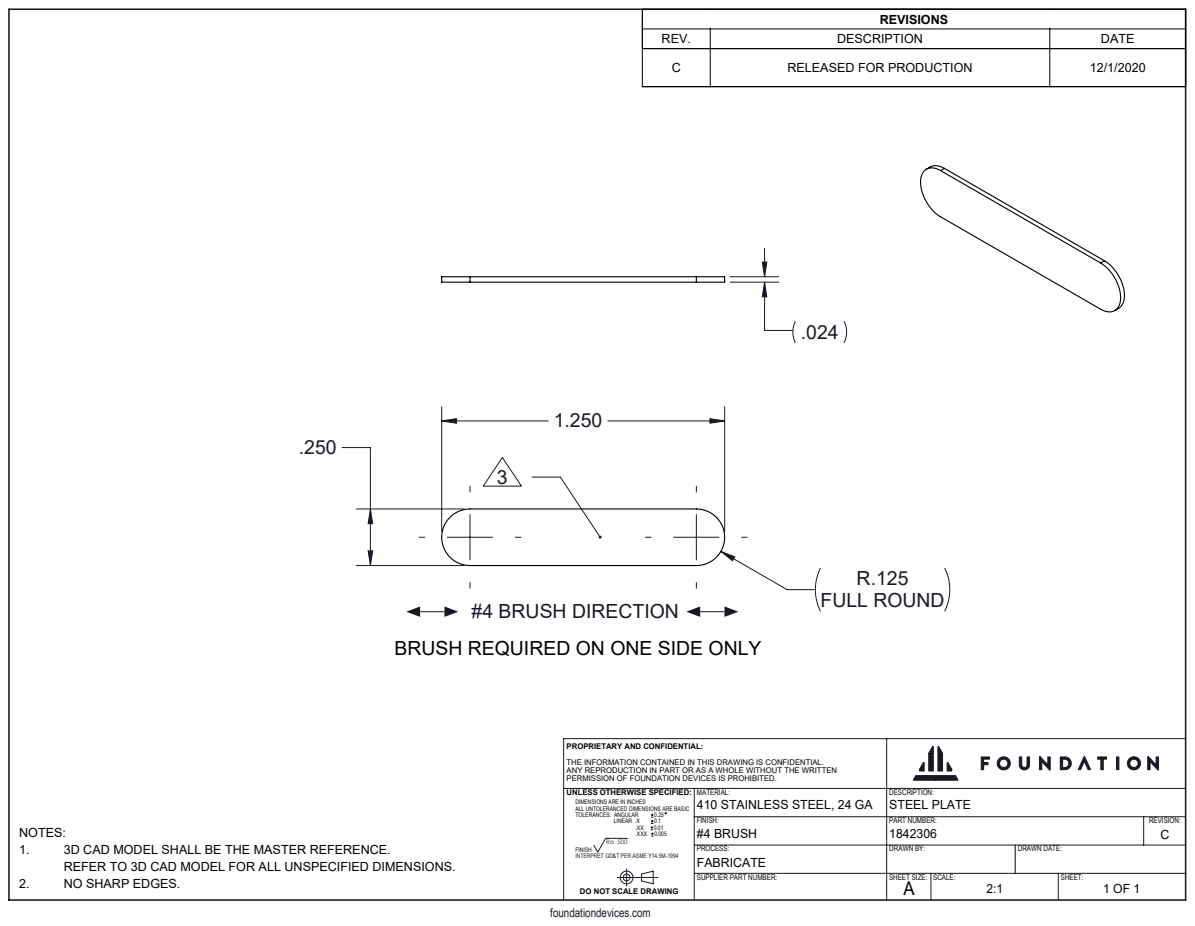
[picture p40: page 1]
FULL ROUND

REVISIONS

REV. | DESCRIPTION | DATE
C | RELEASED FOR PRODUCTION | 12/1/2020

#4 BRUSH DIRECTION
BRUSH REQUIRED ON ONE SIDE ONLY

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

UNLESS OTHERWISE SPECIFIED: DIMENSIONS ARE IN INCHES ALL UNTOLERANCED DIMENSIONS ARE BASIC TOLERANCES: ANGULAR 0.25 LINEAR .X 0.1 .XX 0.01 .XXX 0.005 Ra 500 FINISH INTERPRET GD&T PER ASME Y14.5M-1994 DO NOT SCALE DRAWING | MATERIAL: 410 STAINLESS STEEL, 24 GA | DESCRIPTION: STEEL PLATE

FINISH: #4 BRUSH | PART NUMBER: 1842306 | REVISION: C

NOTES:
1. 3D CAD MODEL SHALL BE THE MASTER REFERENCE.
REFER TO 3D CAD MODEL FOR ALL UNSPECIFIED DIMENSIONS.
2. NO SHARP EDGES.

PROCESS: FABRICATE | DRAWN BY: | DRAWN DATE:
SUPPLIER PART NUMBER: | SHEET SIZE: A | SCALE: 2:1 | SHEET: 1 OF 1
