Foundation-Devices/passport-assembly/Mechanical Design Files/PDF Drawings/FD_1842307-C_Bracket.PDF

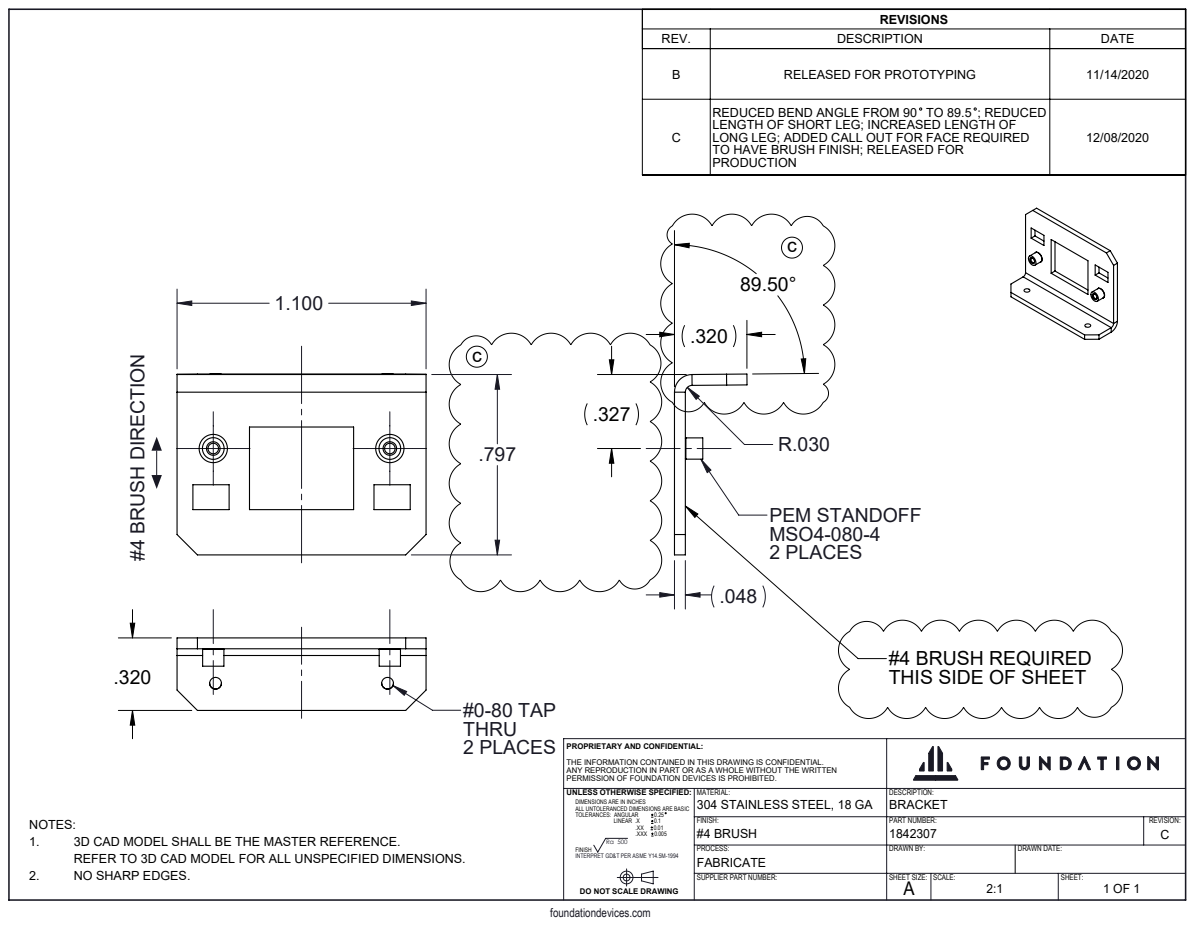
[picture p41: page 1]
#4 BRUSH DIRECTION; PEM STANDOFF 2 PLACES; #4 BRUSH REQUIRED; THIS SIDE OF SHEET; #0-80 TAP 2 PLACES

REVISIONS

REV. | DESCRIPTION | DATE

B | RELEASED FOR PROTOTYPING | 11/14/2020

C | REDUCED BEND ANGLE FROM 90 TO 89.5 ; REDUCED LENGTH OF SHORT LEG; INCREASED LENGTH OF LONG LEG; ADDED CALL OUT FOR FACE REQUIRED TO HAVE BRUSH FINISH; RELEASED FOR PRODUCTION | 12/08/2020

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

UNLESS OTHERWISE SPECIFIED: DIMENSIONS ARE IN INCHES ALL UNTOLERANCED DIMENSIONS ARE BASIC TOLERANCES: ANGULAR 0.25 LINEAR .X 0.1 .XX 0.01 .XXX 0.005 Ra 500 FINISH INTERPRET GD&T PER ASME Y14.5M-1994 DO NOT SCALE DRAWING | MATERIAL: 304 STAINLESS STEEL, 18 GA | DESCRIPTION: BRACKET

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

FINISH: #4 BRUSH | PART NUMBER: 1842307 | REVISION: C

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
