Foundation-Devices/passport-assembly/Mechanical Design Files/PDF Drawings/FD_1842309-D_Retainer.PDF

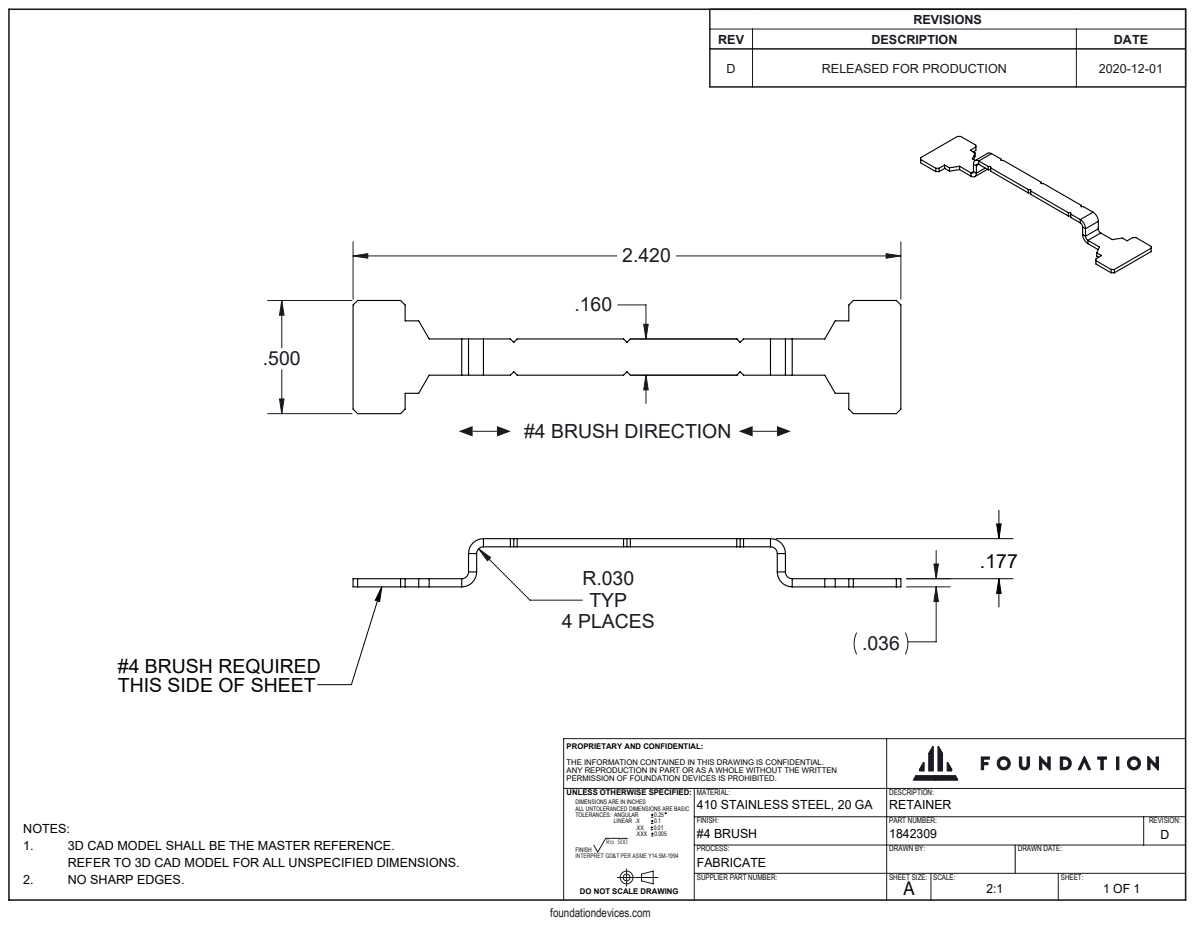
[picture p42: page 1]
4 PLACES; #4 BRUSH DIRECTION

REVISIONS

REV | DESCRIPTION | DATE
D | RELEASED FOR PRODUCTION | 2020-12-01

#4 BRUSH REQUIRED
THIS SIDE OF SHEET

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

UNLESS OTHERWISE SPECIFIED: DIMENSIONS ARE IN INCHES ALL UNTOLERANCED DIMENSIONS ARE BASIC TOLERANCES: ANGULAR 0.25 LINEAR .X 0.1 .XX 0.01 .XXX 0.005 Ra 500 FINISH INTERPRET GD&T PER ASME Y14.5M-1994 DO NOT SCALE DRAWING | MATERIAL: 410 STAINLESS STEEL, 20 GA | DESCRIPTION: RETAINER

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

FINISH: #4 BRUSH | PART NUMBER: 1842309 | REVISION: D

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
