Foundation-Devices/passport-assembly/Mechanical Design Files/PDF Drawings/FD_1842311-C_Display-Foam.PDF

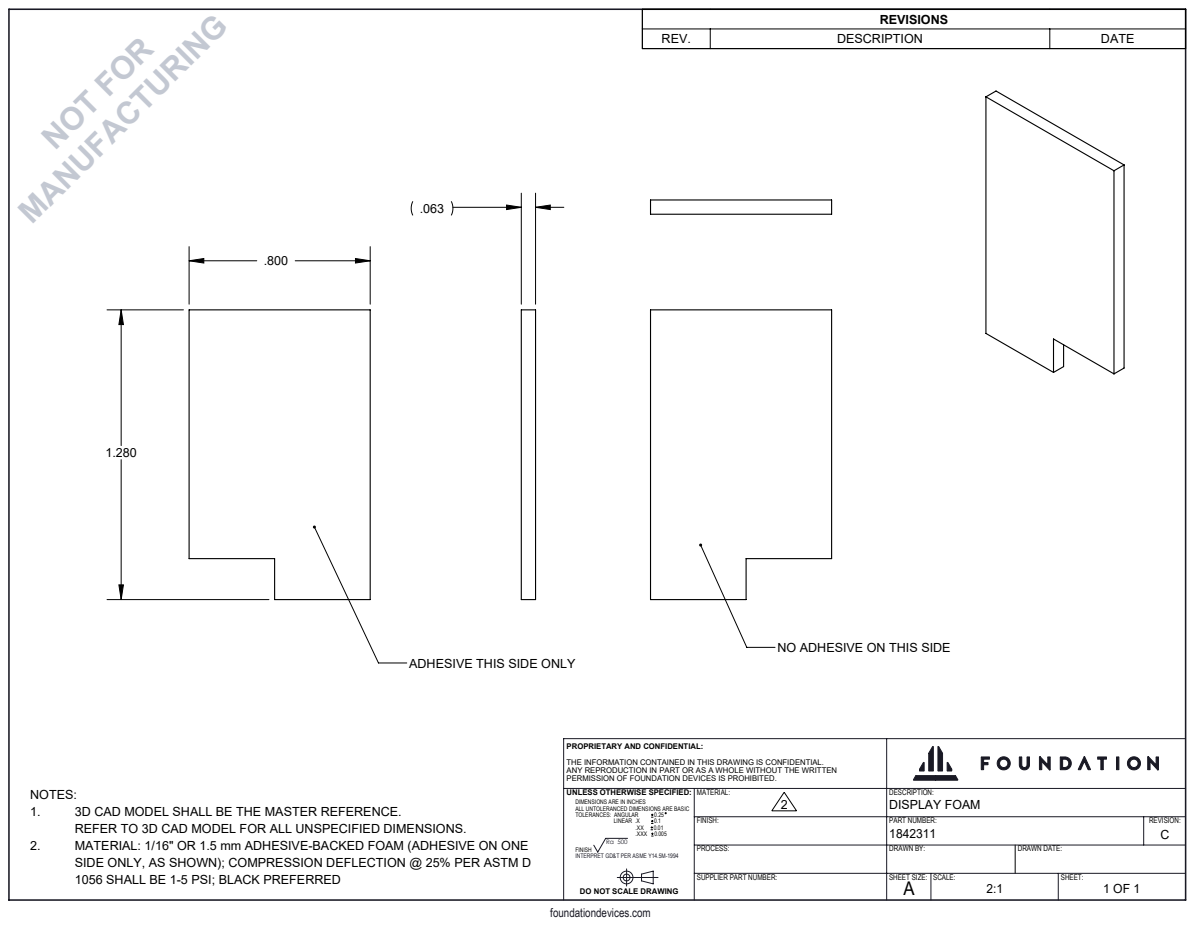
[picture p43: page 1]
NOT FOR

REVISIONS

REV. | DESCRIPTION | DATE

NO ADHESIVE ON THIS SIDE

ADHESIVE THIS SIDE ONLY

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

NOTES:
1. 3D CAD MODEL SHALL BE THE MASTER REFERENCE.
REFER TO 3D CAD MODEL FOR ALL UNSPECIFIED DIMENSIONS.
2. MATERIAL: 1/16" OR 1.5 mm ADHESIVE-BACKED FOAM (ADHESIVE ON ONE
SIDE ONLY, AS SHOWN); COMPRESSION DEFLECTION @ 25% PER ASTM D
1056 SHALL BE 1-5 PSI; BLACK PREFERRED

UNLESS OTHERWISE SPECIFIED: DIMENSIONS ARE IN INCHES ALL UNTOLERANCED DIMENSIONS ARE BASIC TOLERANCES: ANGULAR 0.25 LINEAR .X 0.1 .XX 0.01 .XXX 0.005 Ra 500 FINISH INTERPRET GD&T PER ASME Y14.5M-1994 DO NOT SCALE DRAWING | MATERIAL: 2 | DESCRIPTION: DISPLAY FOAM

FINISH: | PART NUMBER: 1842311 | REVISION: C

PROCESS: | DRAWN BY: | DRAWN DATE:
SUPPLIER PART NUMBER: | SHEET SIZE: A | SCALE: 2:1 | SHEET: 1 OF 1
