Foundation-Devices/passport-assembly/(commit log)

2021-05-18 added BOMs
    [BOM.csv, BOM.xlsx]
2021-05-18 added link to full STL and STEP assemblies
